DvidMakesThings/HW_DataForge-DAQ/src/COMPONENTS.md

## Core Microcontroller

- **RP2354B**: Dual Cortex-M33 or Hazard3 RISC-V processors at 150 MHz.
- **Integrated ADC**: 8 channels, used for general-purpose analog input.
- **Integrated UART, SPI, I2C, PWM**: For flexible communication and control.

## Networking

- **RTL8211F**: Gigabit Ethernet PHY.
  - Connects to the RP2354B via the RMII interface.
  - Requires a 25 MHz crystal for clock input.
  - Magnetics and RJ45 jack directly interface with the network.

## Analog Input Subsystem

- **ADS1255**: External 24-bit ADC for high-precision measurements (connected via SPI).
- **AD8253**: Programmable Gain Amplifier for scalable input ranges.
- **DG409**: Dual 4-channel analog multiplexer for input selection.
- **ADA4254**: Programmable Gain Instrumentation Amplifier for signal scaling and conditioning.

## Analog Output Subsystem

- **DAC8568**: 16-bit external DAC for generating 8-channel analog output.
- **TLV2372**: Operational amplifiers for output buffering.
- **Output Voltage Range**: Configurable from 0-5V.

## Digital I/O Subsystem

- **LSF0108-Q1**: Used for bidirectional translation between the RP2354B's GPIOs (3.3V logic) and external interfaces that might use different logic levels (e.g., 1.8V, 5V).

## Communication Subsystem

- **RS-232 and RS-485**:
  - MAX3232 and MAX485 for serial communication.
- **CAN**: MCP2515 (SPI-based CAN controller) with a TJA1051 transceiver.
- **USB**: Integrated USB 1.1 host/device controller in RP2354B for PC connectivity.

## Power Supply

- **Input Voltage Range**: 9-24V DC.
- **Voltage Regulation**:
  - LM2596 for 5V.
  - AMS1117 for 3.3V (RP2354B and peripherals).
- **Protection**:
  - Reverse polarity and overvoltage protection.
  - ESD diodes on all power and communication lines.
