DvidMakesThings/HW_DataForge-DAQ/tests/Readme.md

# DataForge-DAQ Project Test files
This folder contains the main test files for the DataForge-DAQ project.
## Contents
- Various test scripts and files for the DataForge-DAQ project.
## Usage
1. Clone the repository.
2. Navigate to this folder.
3. Run the test scripts as needed.
## License
This project is licensed under the MIT License.
## Contact
For any questions or feedback, please contact:
- Email: [s.dvid@hotmail.com](mailto:s.dvid@hotmail.com)
- GitHub: [DvidMakesThings](https://github.com/DvidMakesThings)
