DvidMakesThings/HW_DataForge-DAQ/src/HardwareDesign/DataForge-DAQ_Schematics.pdf

Document Number: | REV: v1.0
Date: not saved! | Sheet: 1/7

## https://github.com/DvidMakesThings

# BLOCK DIAGRAM

USB-C | POWER DELIVERY

# BOOST INVERTER TPS65131

# DUAL LDO TPS7A39

V+
+12V
V-
-12V

# LDO

# REF

# LDO

3.3V

1.8V

2.5V

+/-15V

# REF/2

1.25V

5V | 5V

# ANALOG

INPUT MUX | CON2
| AI
ANALOG | AO

# OUTPUT

24 BIT ADC | PGA
MCU | CON1
DIOCON³ | INTERFACING

## TITLE:

## DataForge-DAQ

# 5V to +/-14V BOOST CONVERTER

# +/-14V to +/12V LDO

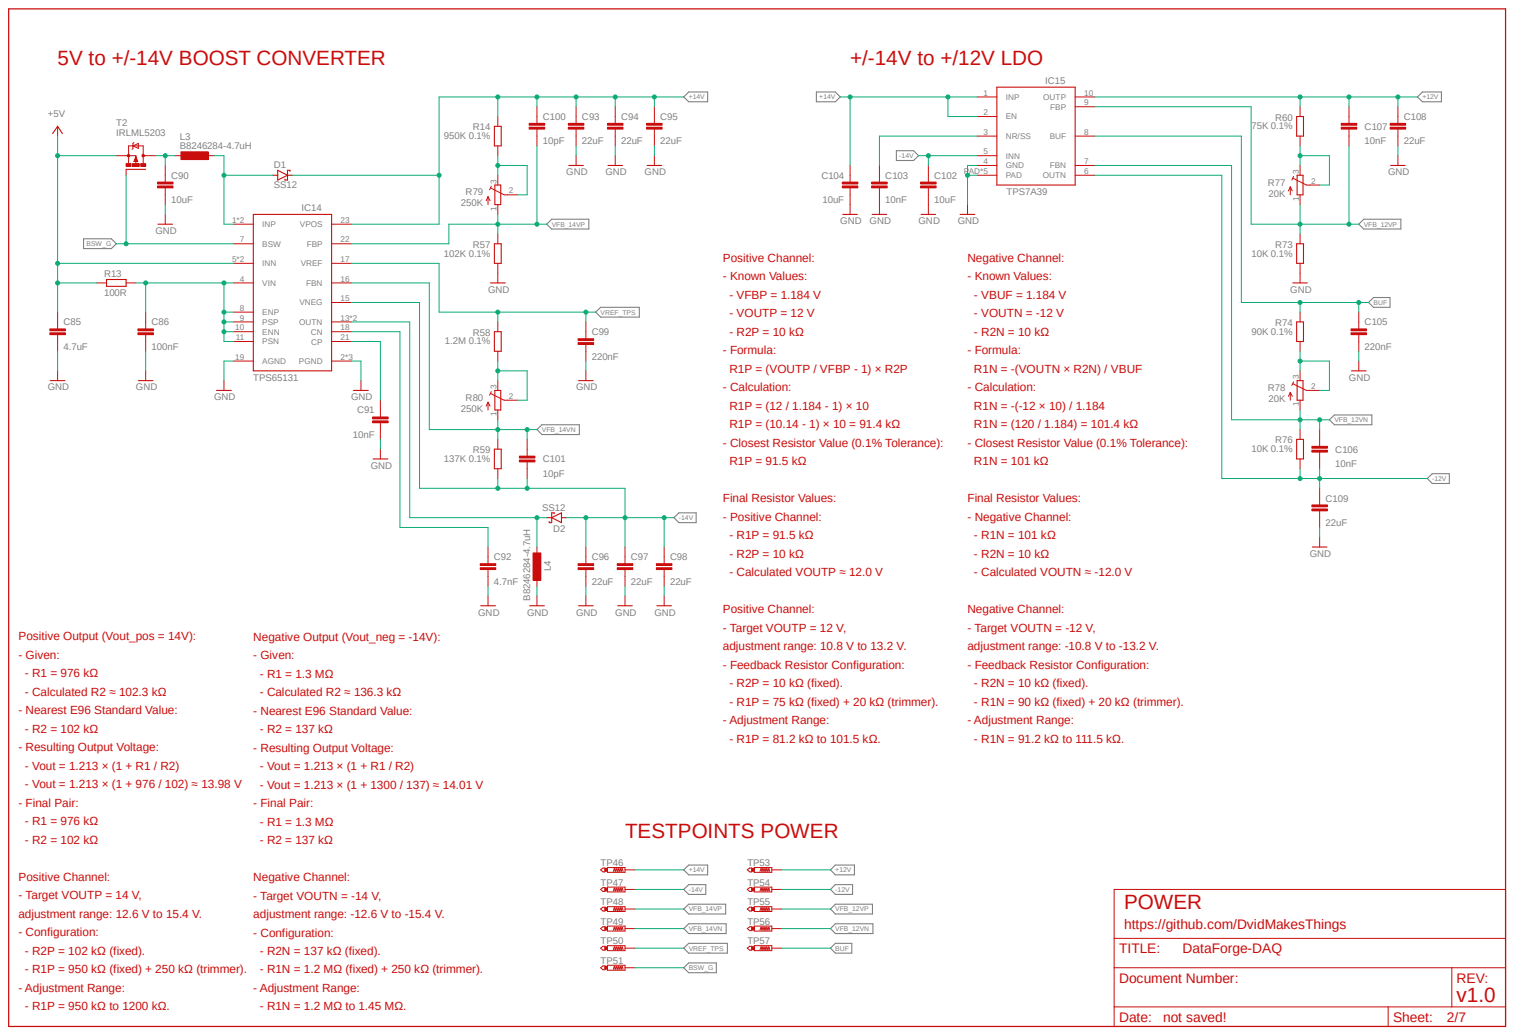
[picture p1: page 2]

Positive Channel:
- Target VOUTP = 12 V,
adjustment range: 10.8 V to 13.2 V.
- Feedback Resistor Configuration:
- R2P = 10 kΩ (fixed).
- R1P = 75 kΩ (fixed) + 20 kΩ (trimmer).
- Adjustment Range:

Negative Channel:
- Target VOUTN = -12 V,
adjustment range: -10.8 V to -13.2 V.
- R2N = 10 kΩ (fixed).
- R1N = 90 kΩ (fixed) + 20 kΩ (trimmer).

- Target VOUTP = 14 V,
adjustment range: 12.6 V to 15.4 V.
- Configuration:
- R2P = 102 kΩ (fixed).
- R1P = 950 kΩ (fixed) + 250 kΩ (trimmer).

- Target VOUTN = -14 V,
adjustment range: -12.6 V to -15.4 V.
- R2N = 137 kΩ (fixed).
- R1N = 1.2 MΩ (fixed) + 250 kΩ (trimmer).

POWER
https://github.com/DvidMakesThings
TITLE:

## CC1 D+D- CC2

# USB-C

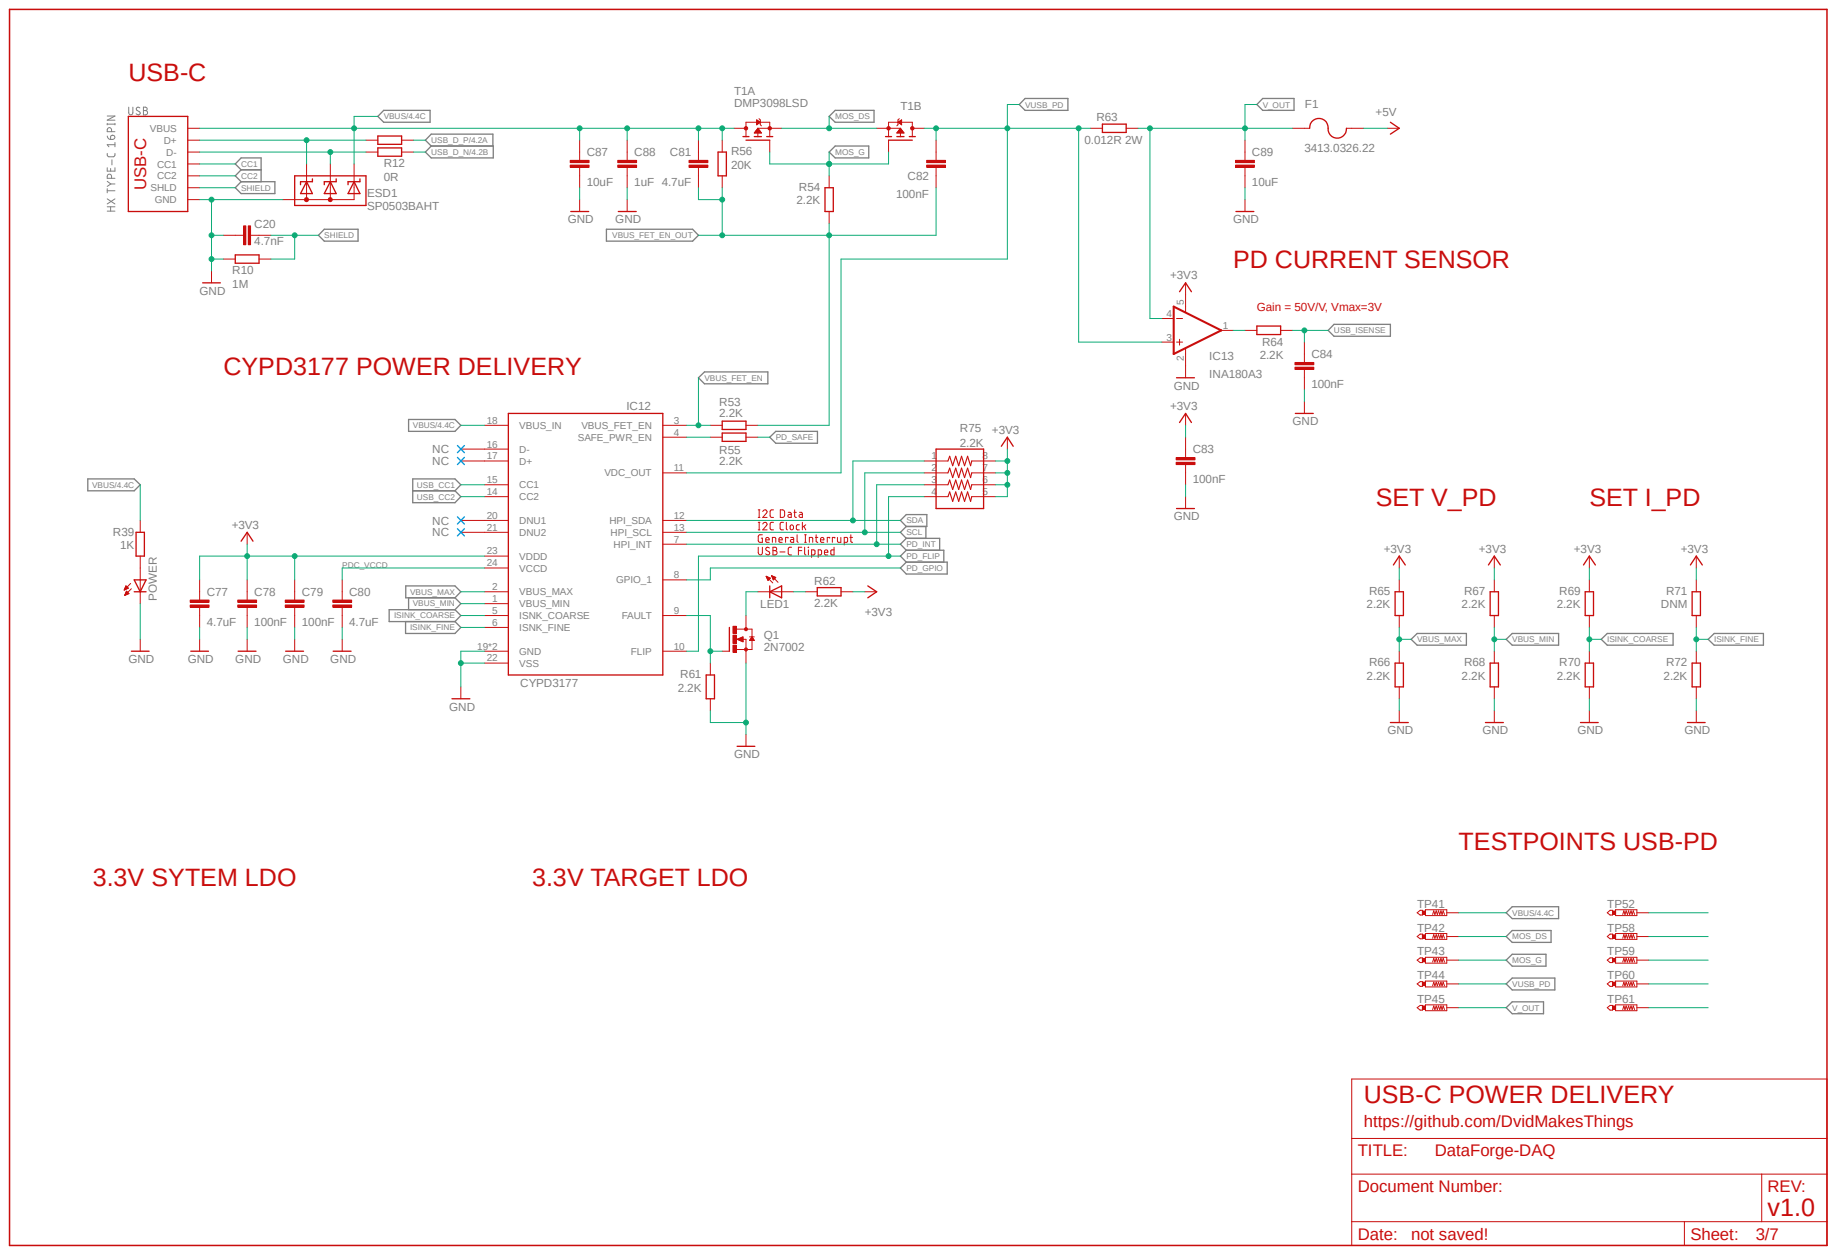
[picture p2: page 3]

USB-C POWER DELIVERY
https://github.com/DvidMakesThings
TITLE:

# RP2354 MCU

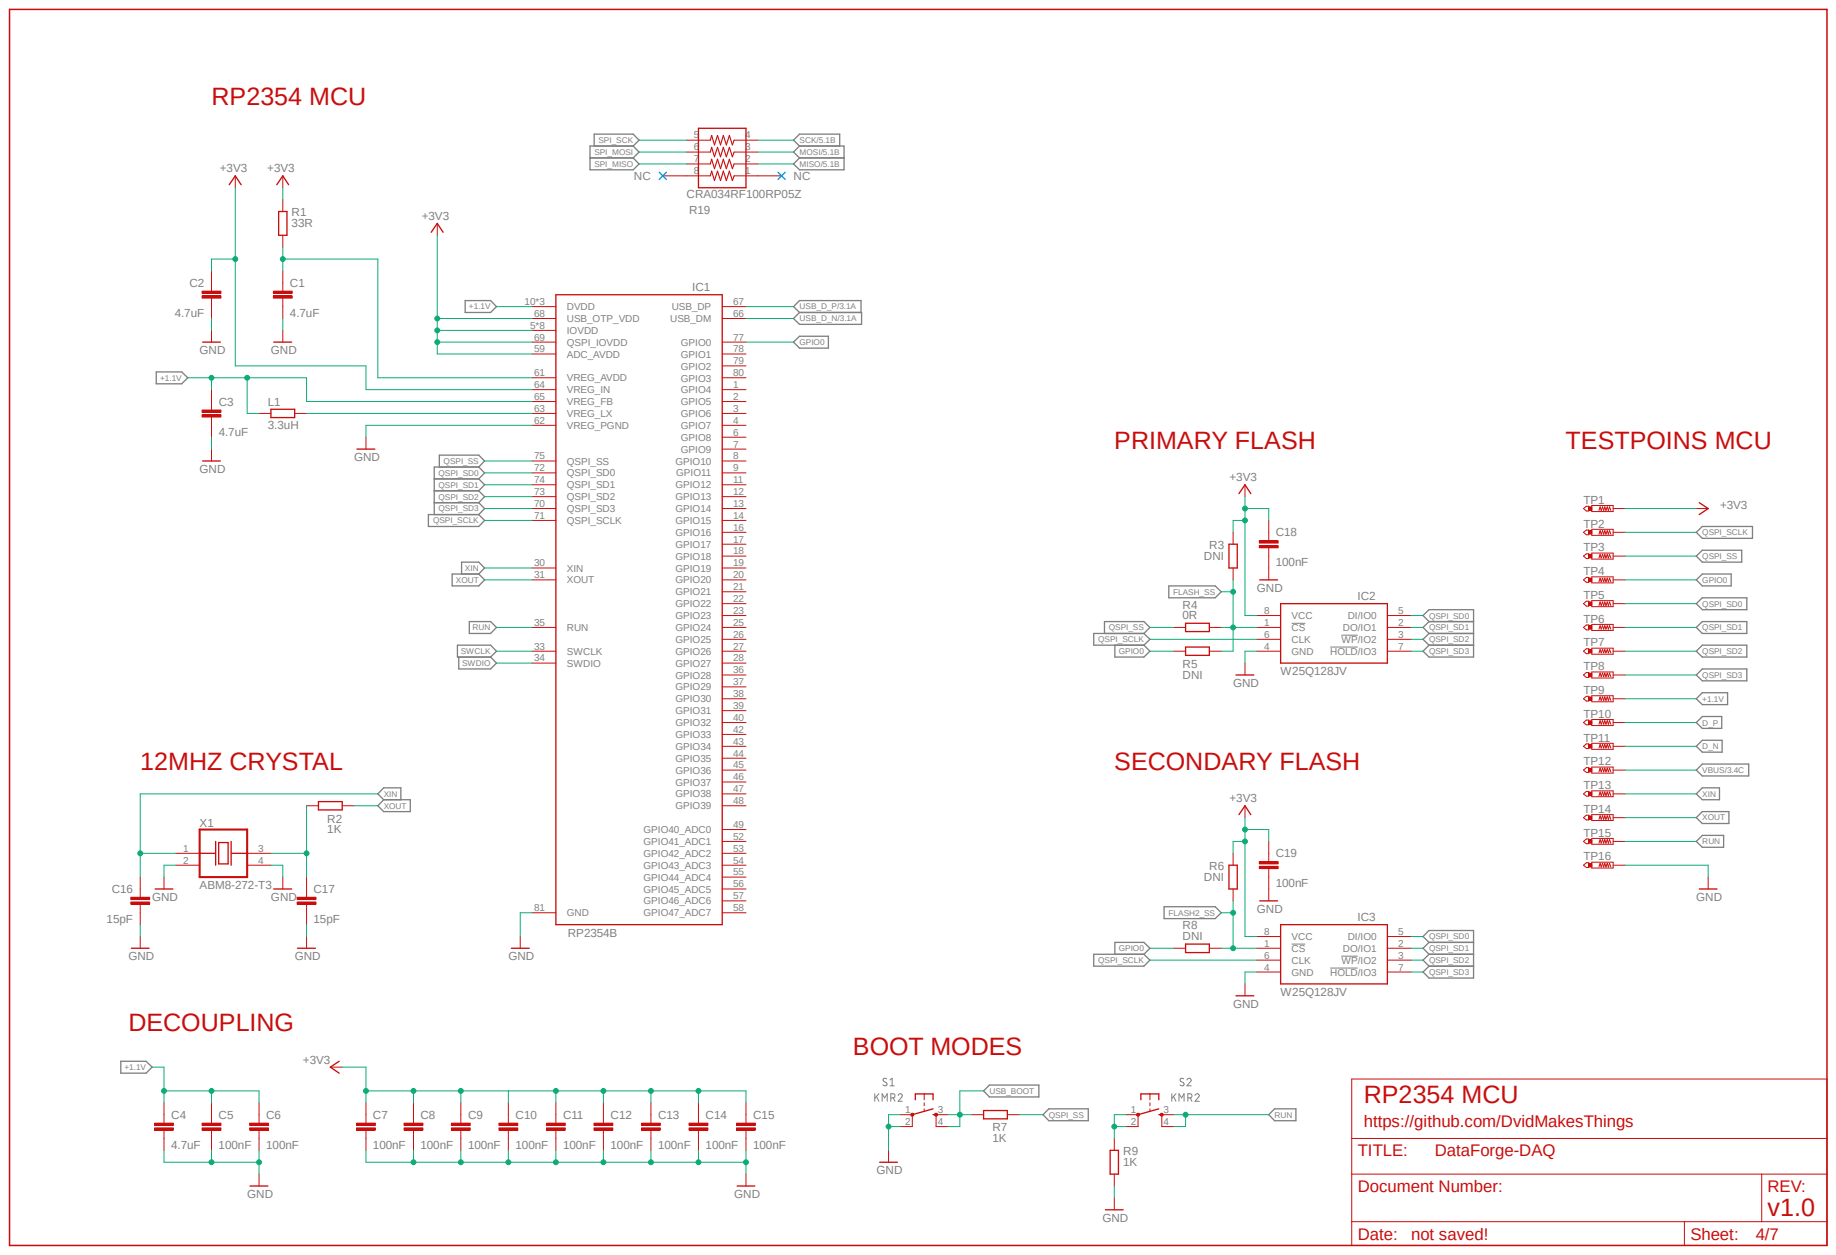
[picture p3: page 4]

RP2354 MCU
https://github.com/DvidMakesThings
TITLE:

A0 1 | EN 2 | A1 16 | V+ 14 | V- 3

# ADS1256 ADC

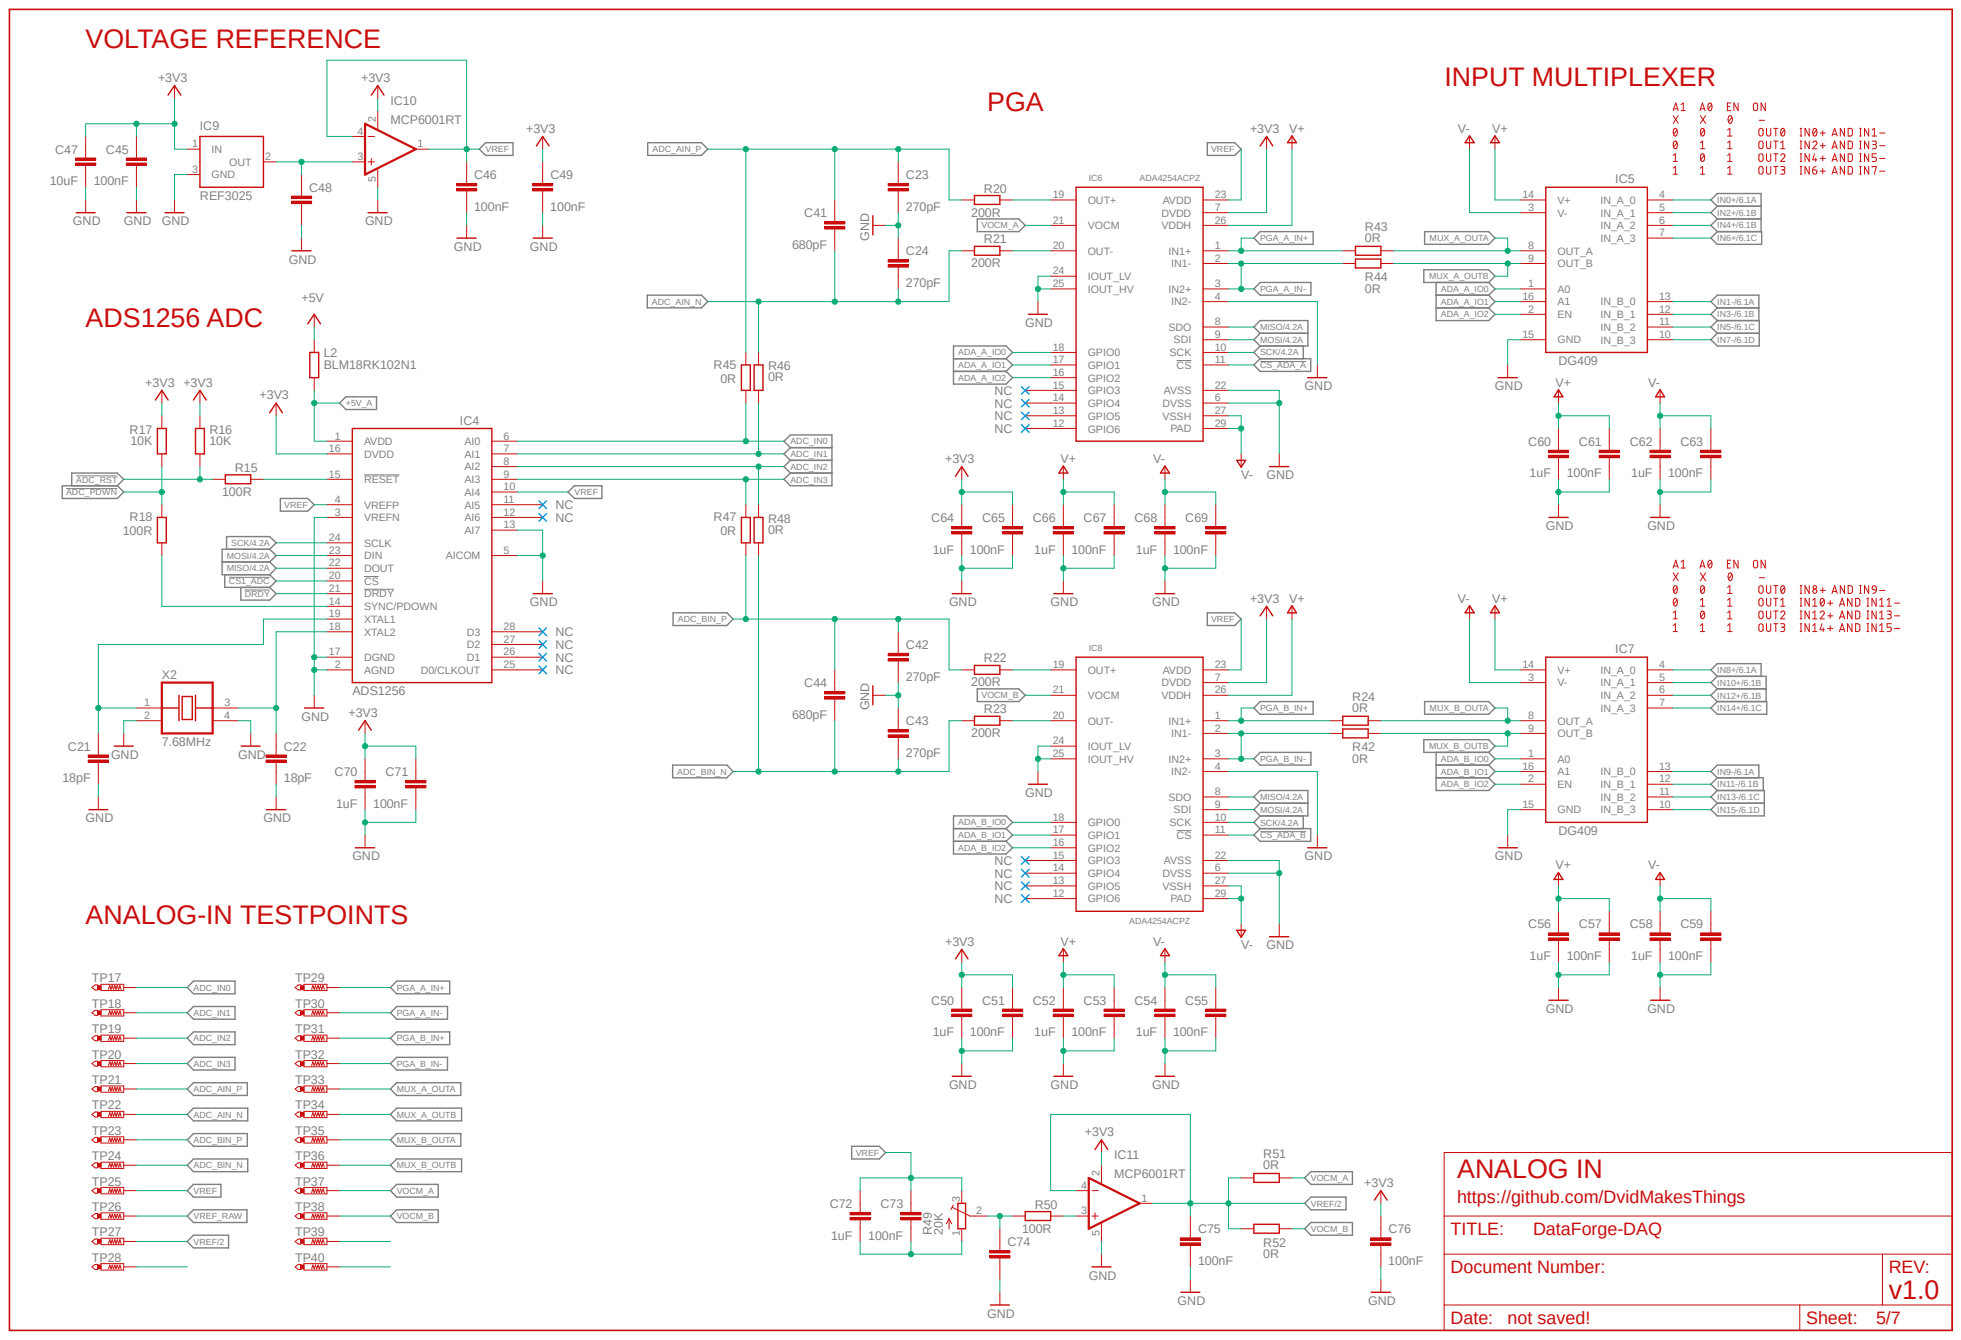
[picture p4: page 5]

ANALOG IN
https://github.com/DvidMakesThings
TITLE:

# ADC INPUTS

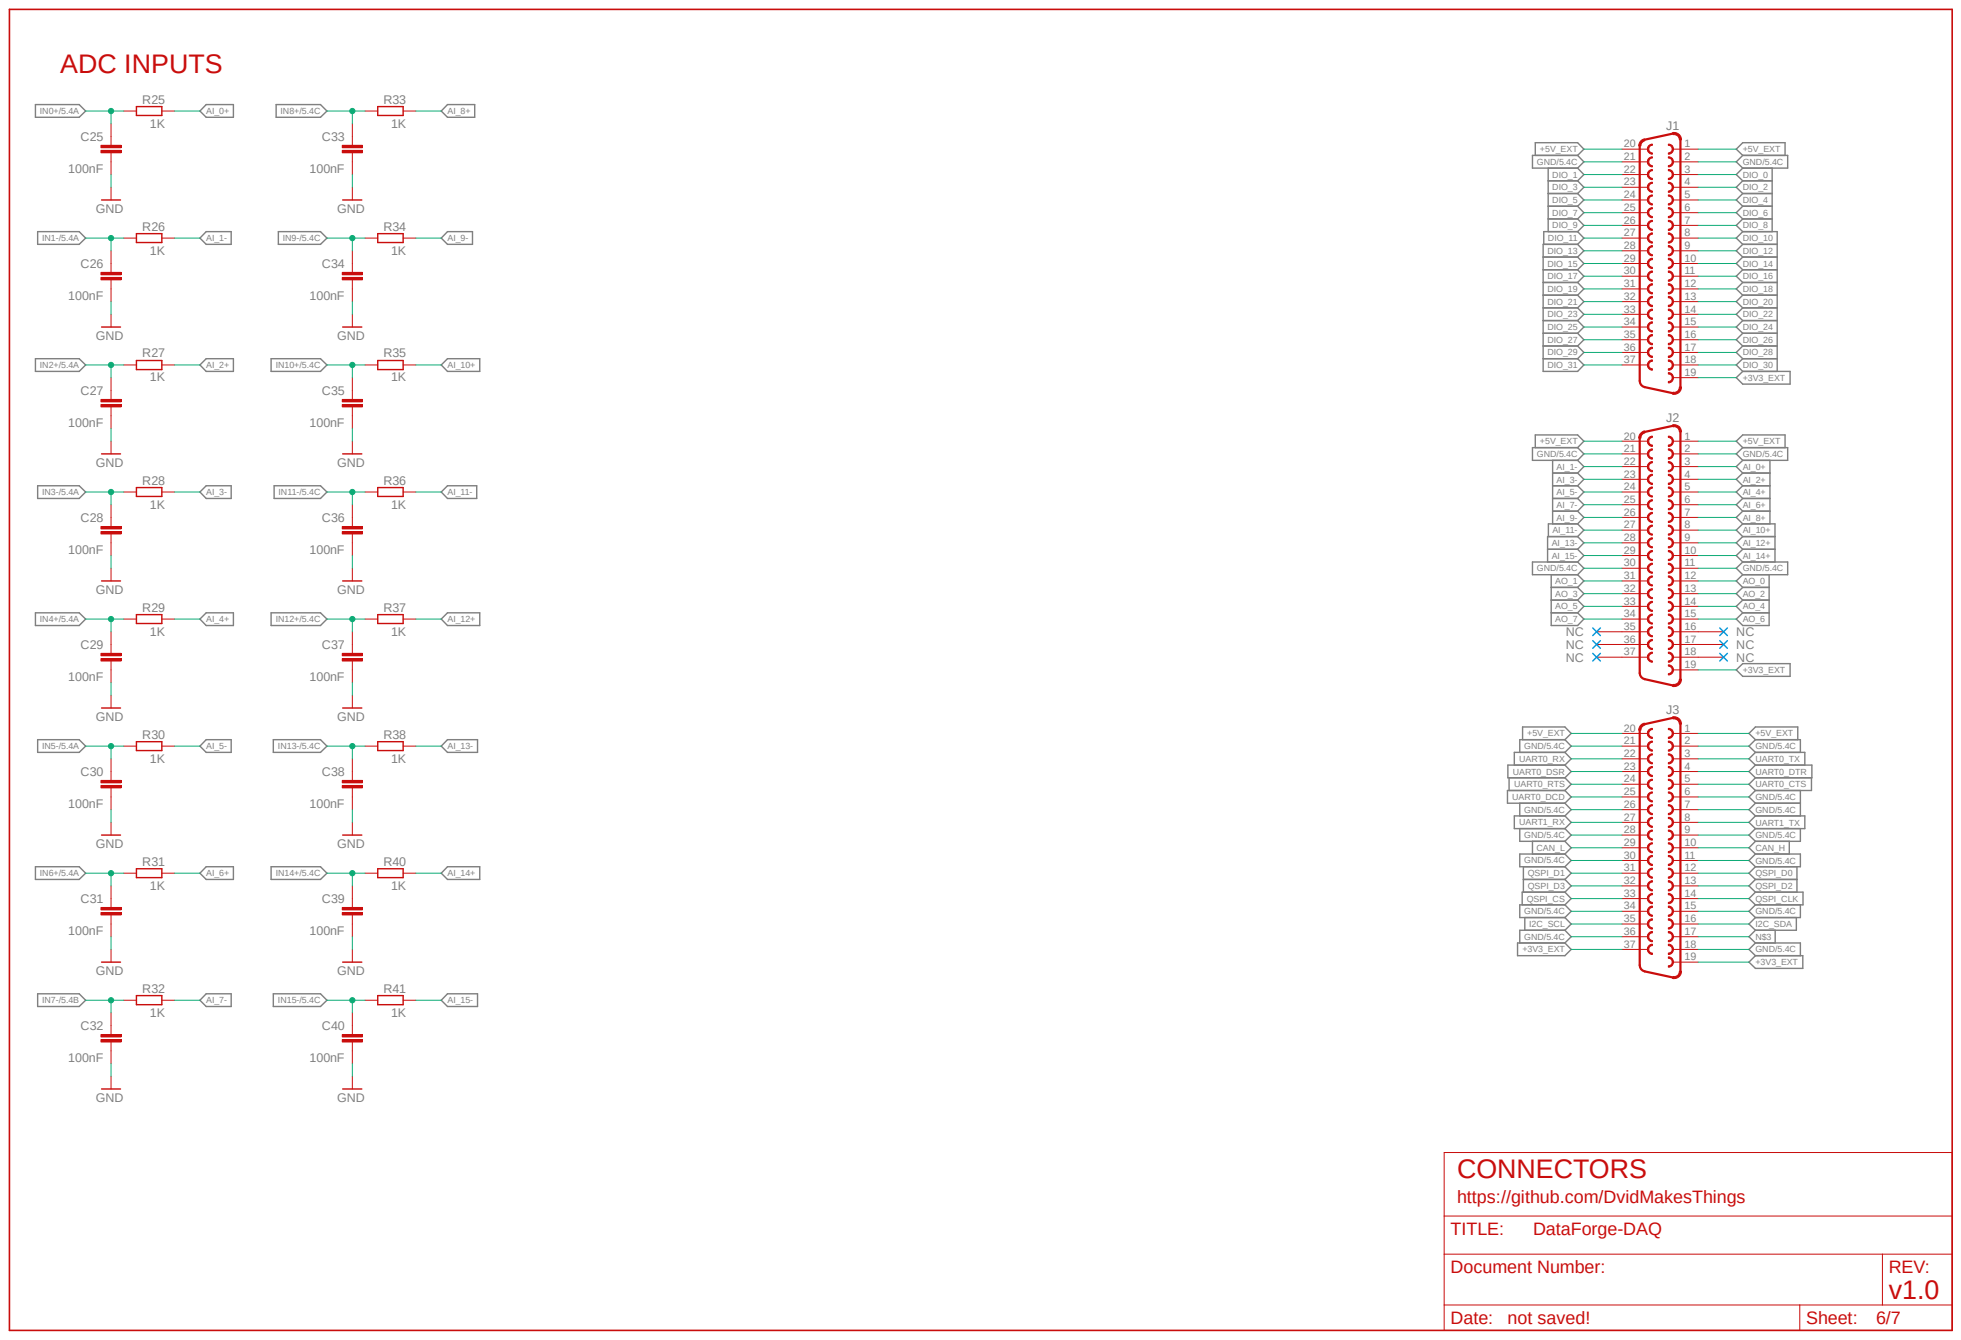
[picture p5: page 6]

CONNECTORS
https://github.com/DvidMakesThings
TITLE:
