DvidMakesThings/HW_DataForge-DAQ/src/HardwareDesign/DataForge-DAQ.sch

## EAGLE design src/HardwareDesign/DataForge-DAQ.sch (2024-12-25)

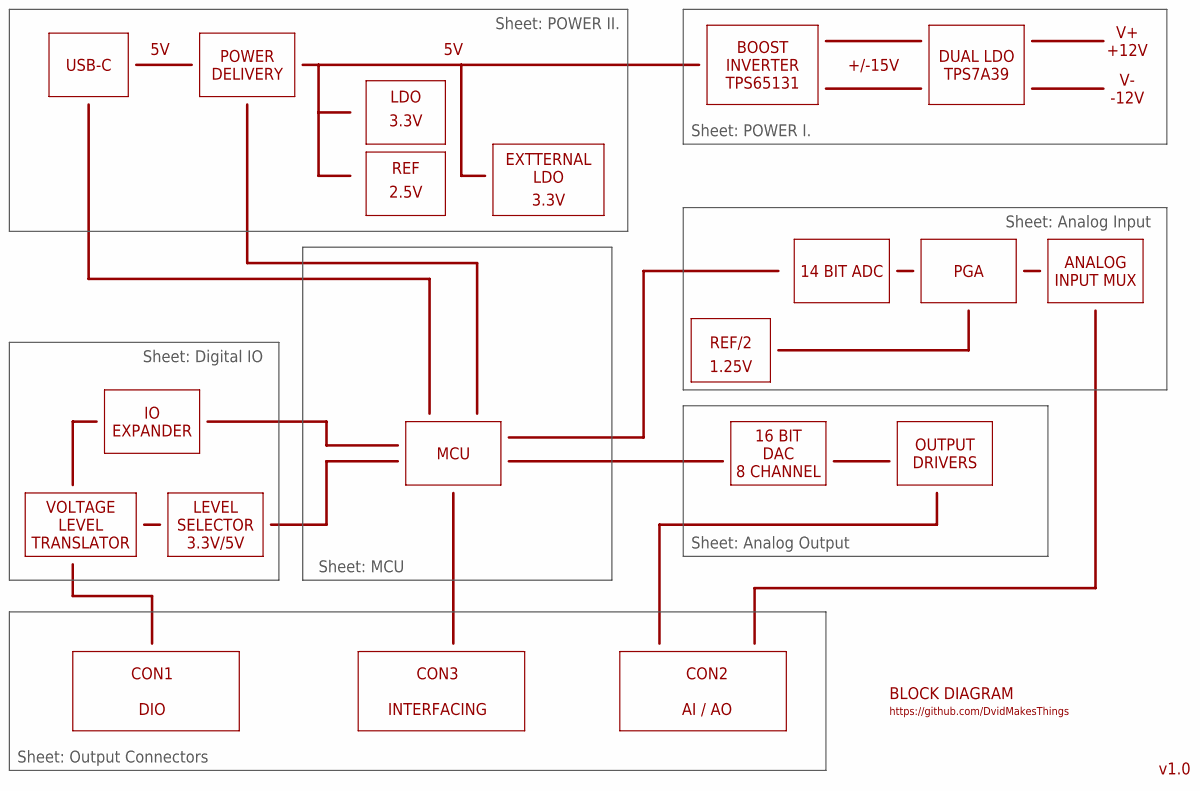
[picture p6: schematic DataForge-DAQ.sch, sheet 1]

Notes on the sheet:
v1.0
https://github.com/DvidMakesThings
BLOCK DIAGRAM
USB-C
POWER DELIVERY
BOOST INVERTER TPS65131
DUAL LDO TPS7A39
V+ +12V
V- -12V
LDO
REF
3.3V
2.5V
+/-15V
REF/2
1.25V
ANALOG INPUT MUX
CON2 AI / AO
16 BIT DAC 8 CHANNEL
PGA
14 BIT ADC
MCU
CON1 DIO
CON3 INTERFACING
EXTTERNAL LDO
Sheet: POWER I.
Sheet: POWER II.
Sheet: MCU
Sheet: Analog Output
Sheet: Analog Input
Sheet: Output Connectors
Sheet: Digital IO
OUTPUT DRIVERS
VOLTAGE LEVEL TRANSLATOR
LEVEL SELECTOR 3.3V/5V
IO EXPANDER

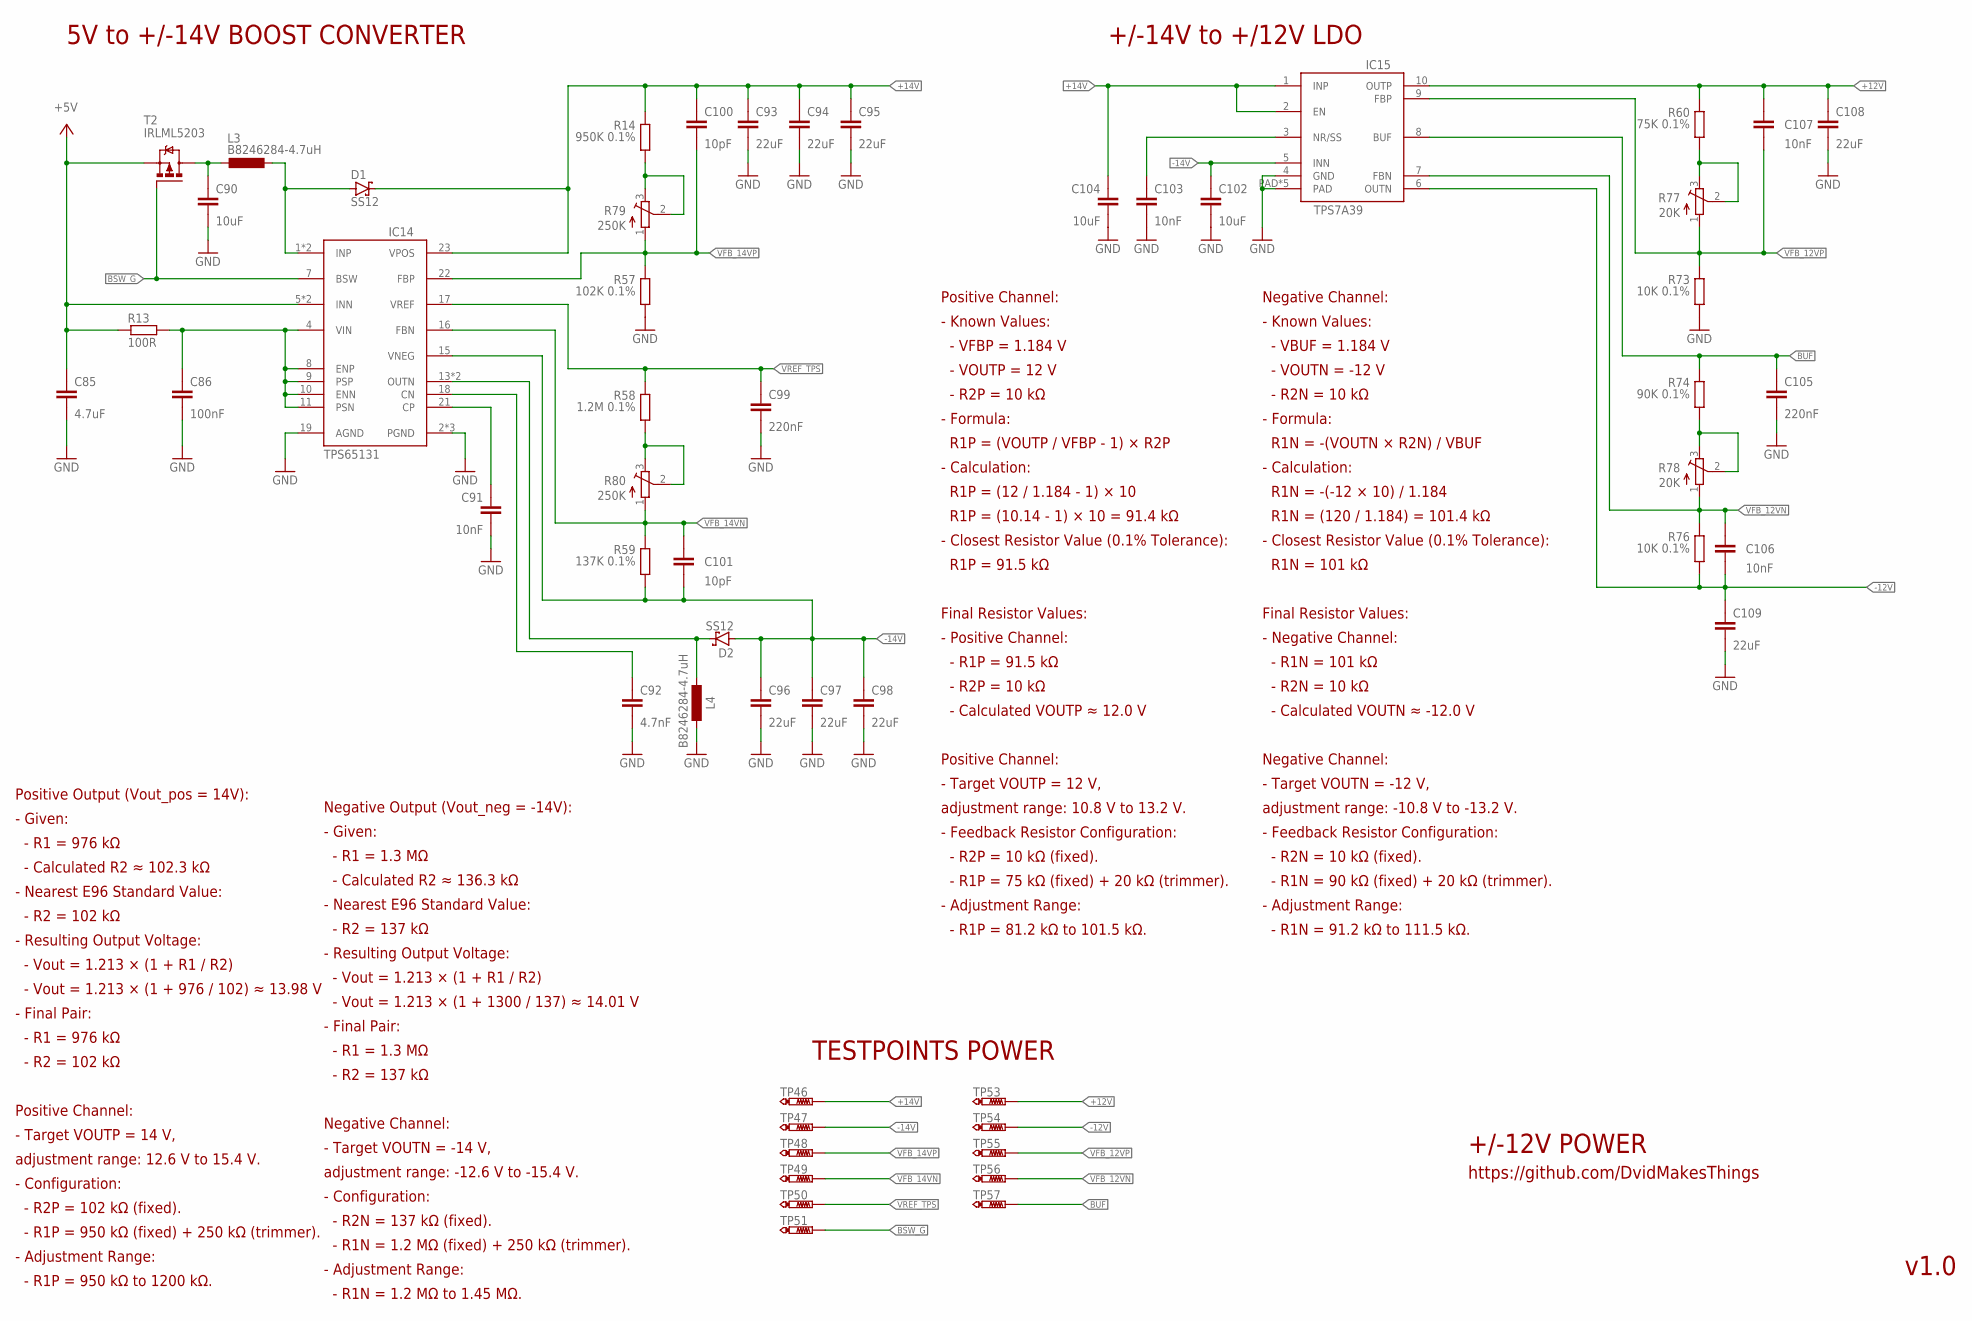
[picture p7: schematic DataForge-DAQ.sch, sheet 2]

Parts:
C85: 4.7uF; 0805
C86: 100nF; 0805
C90: 10uF; 0805
C91: 10nF; 0805
C92: 4.7nF; 0805
C93, C94, C95, C96, C97, C98, C108, C109: 22uF; 1206
C99, C105: 220nF; 0402
C100, C101: 10pF; 0402
C102, C104: 10uF; 1206
C103: 10nF; 1206
C106, C107: 10nF; 0402
D1, D2: SS12; SMA
IC14: TPS65131; VQFN24-4X4-THERMAL2.5X2.5
IC15: TPS7A39; WSON10-3X3
L3, L4: B8246284-4.7uH; MSS7341
R13: 100R; 1206
R14: 950K 0.1%; 0402
R57: 102K 0.1%; 0402
R58: 1.2M 0.1%; 0402
R59: 137K 0.1%; 0402
R60: 75K 0.1%; 0402
R73, R76: 10K 0.1%; 0402
R74: 90K 0.1%; 0402
R77, R78: 20K; 3223G
R79, R80: 250K; 3223G
T2: IRLML5203; MICRO3
TP46, TP47, TP48, TP49, TP50, TP51, TP53, TP54, TP55, TP56, TP57: PTR1B1,27; B1,27

Connections:
+5V: C85.1, IC14.5 (INN), R13.2, T2.2 (S)
+12V: C107.2, C108.1, IC15.10 (OUTP), R60.1, TP53.TP
+14V: C93.1, C94.1, C95.1, C100.1, C104.1, D1.C, IC14.23 (VPOS), IC15.1 (INP), IC15.2 (EN), R14.1, TP46.TP
-12V: C106.1, C109.1, IC15.6 (OUTN), R76.2, TP54.TP
-14V: C96.1, C97.1, C98.1, C101.1, C102.1, D2.A, IC14.15 (VNEG), IC15.5 (INN), R59.2, TP47.TP
BSW_G: IC14.7 (BSW), T2.1 (G), TP51.TP
BUF: C105.2, IC15.8 (BUF), R74.1, TP57.TP
GND: C85.2, C86.2, C90.2, C91.2, C92.2, C93.2, C94.2, C95.2, C96.2, C97.2, C98.2, C99.1, C102.2, C103.2, C104.2, C105.1, C108.2, C109.2, IC14.2 (PGND), IC14.19 (AGND), IC15.4 (GND), IC15.PAD, L4.1, R57.2, R73.2
unnamed: D1.A, IC14.1 (INP), L3.2
unnamed: C90.1, L3.1, T2.3 (D)
unnamed: C86.1, IC14.4 (VIN), IC14.8 (ENP), IC14.9 (PSP), IC14.10 (ENN), IC14.11 (PSN), R13.1
unnamed: C91.1, IC14.21 (CP)
unnamed: C92.1, IC14.18 (CN)
unnamed: D2.C, IC14.13 (OUTN), L4.2
unnamed: R60.2, R77.2 (S), R77.3 (E)
unnamed: C103.1, IC15.3 (NR/SS)
unnamed: R74.2, R78.2 (S), R78.3 (E)
unnamed: R14.2, R79.2 (S), R79.3 (E)
unnamed: R58.2, R80.2 (S), R80.3 (E)
VFB_12VN: C106.2, IC15.7 (FBN), R76.1, R78.1 (A), TP56.TP
VFB_12VP: C107.1, IC15.9 (FBP), R73.1, R77.1 (A), TP55.TP
VFB_14VN: C101.2, IC14.16 (FBN), R59.1, R80.1 (A), TP49.TP
VFB_14VP: C100.2, IC14.22 (FBP), R57.1, R79.1 (A), TP48.TP
VREF_TPS: C99.2, IC14.17 (VREF), R58.1, TP50.TP

Notes on the sheet:
v1.0
https://github.com/DvidMakesThings
+/-12V POWER
5V to +/-14V BOOST CONVERTER
Positive Output (Vout_pos = 14V): - Given: - R1 = 976 kΩ - Calculated R2 ≈ 102.3 kΩ - Nearest E96 Standard Value: - R2 = 102 kΩ - Resulting Output Voltage: - Vout = 1.213 × (1 + R1 / R2) - Vout = 1.213 × (1 + 976 / 102) ≈ 13.98 V - Final Pair: - R1 = 976 kΩ - R2 = 102 kΩ Positive Channel: - Target 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
Negative Output (Vout_neg = -14V): - Given: - R1 = 1.3 MΩ - Calculated R2 ≈ 136.3 kΩ - Nearest E96 Standard Value: - R2 = 137 kΩ - Resulting Output Voltage: - Vout = 1.213 × (1 + R1 / R2) - Vout = 1.213 × (1 + 1300 / 137) ≈ 14.01 V - Final Pair: - R1 = 1.3 MΩ - R2 = 137 kΩ Negative Channel: - Targe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
Positive Channel: - Known Values: - VFBP = 1.184 V - VOUTP = 12 V - R2P = 10 kΩ - Formula: R1P = (VOUTP / VFBP - 1) × R2P - Calculation: R1P = (12 / 1.184 - 1) × 10 R1P = (10.14 - 1) × 10 = 91.4 kΩ - Closest Resistor Value (0.1% Tolerance): R1P = 91.5 kΩ Final Resistor Values: - Positive Channel: -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
Negative Channel: - Known Values: - VBUF = 1.184 V - VOUTN = -12 V - R2N = 10 kΩ - Formula: R1N = -(VOUTN × R2N) / VBUF - Calculation: R1N = -(-12 × 10) / 1.184 R1N = (120 / 1.184) = 101.4 kΩ - Closest Resistor Value (0.1% Tolerance): R1N = 101 kΩ Final Resistor Values: - Negative Channel: - R1N = 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
+/-14V to +/12V LDO
TESTPOINTS POWER

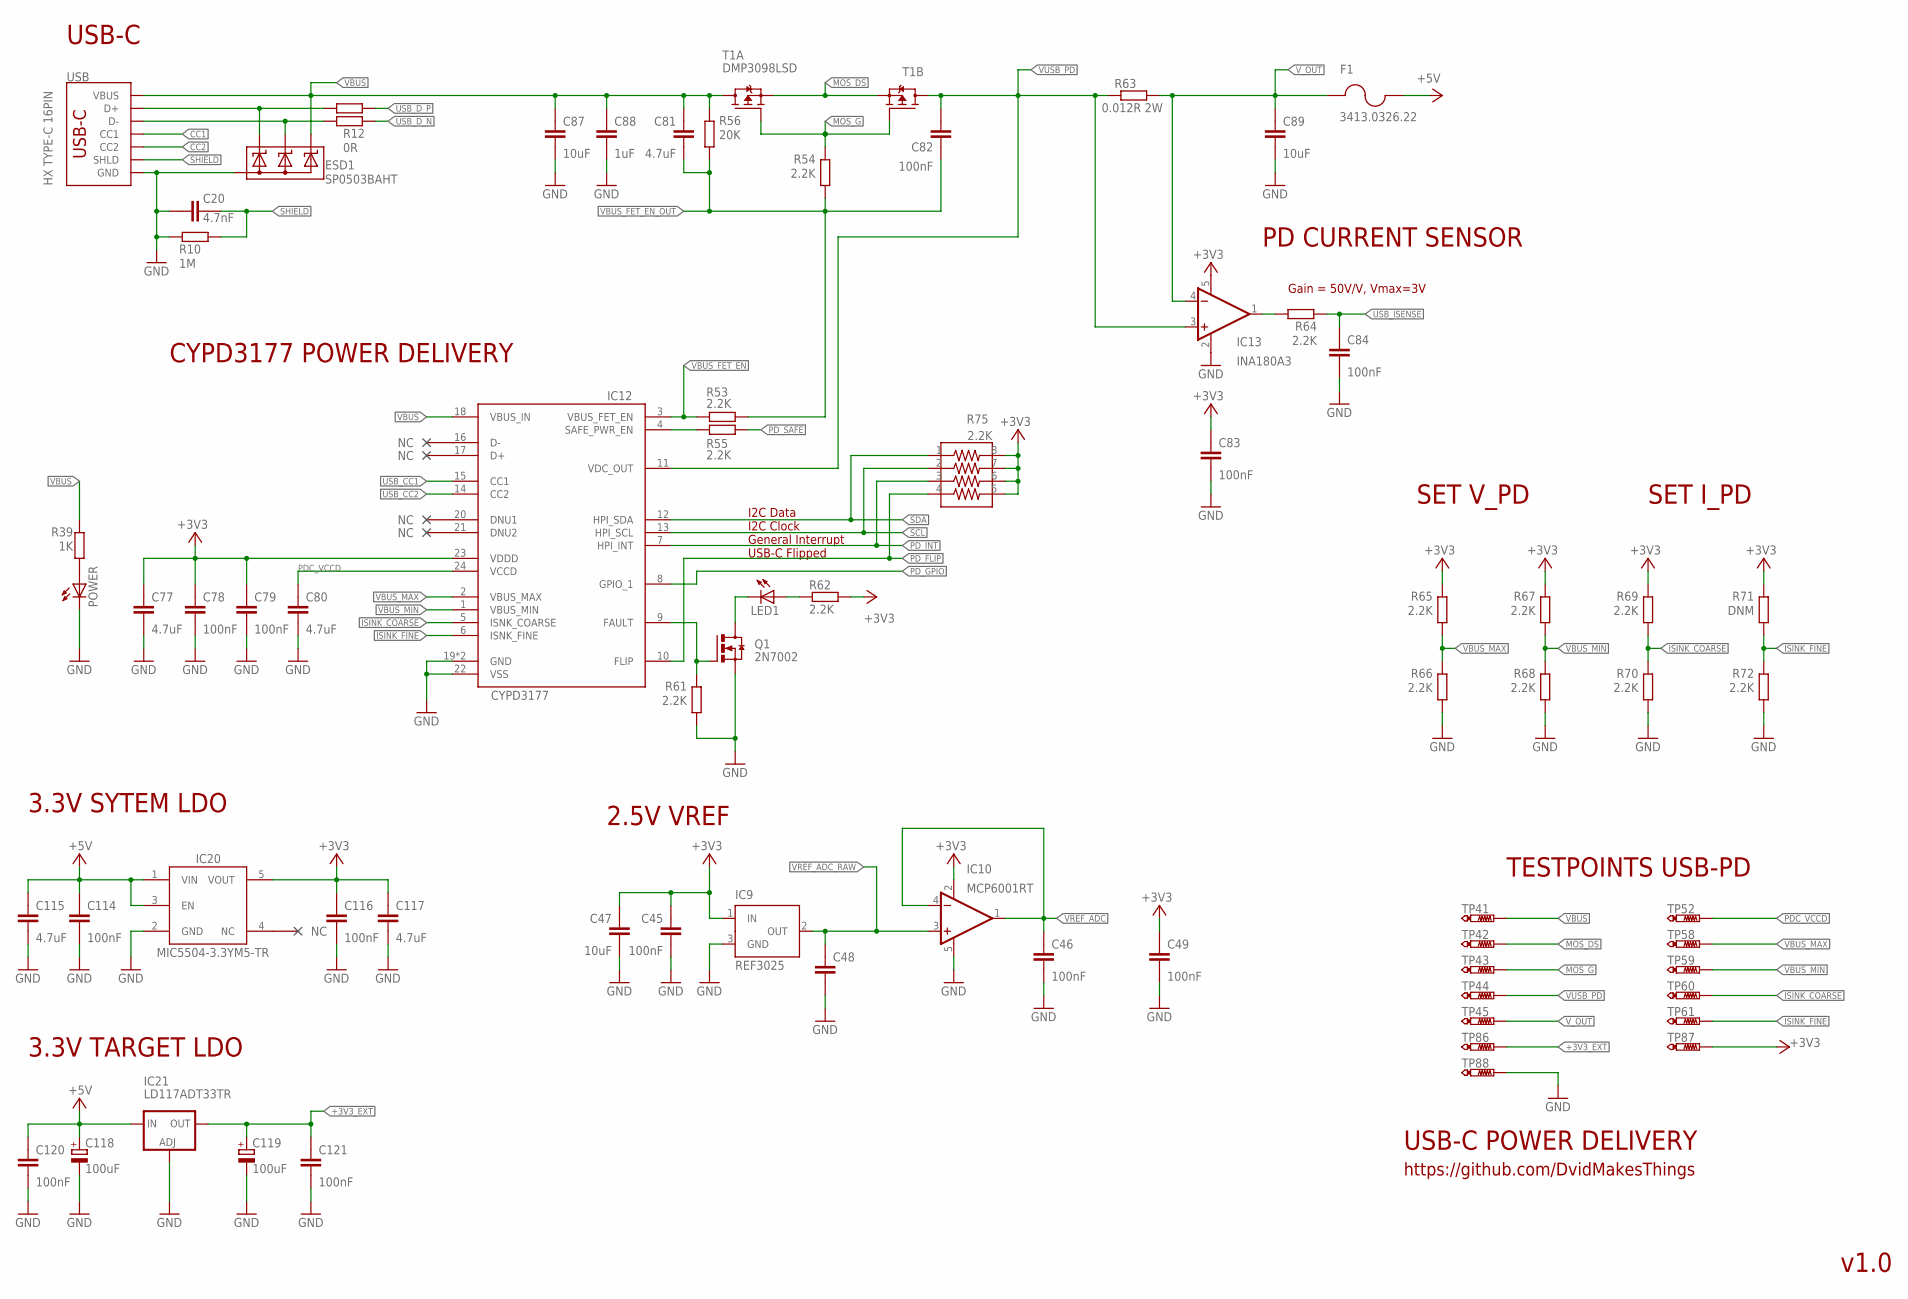
[picture p8: schematic DataForge-DAQ.sch, sheet 3]

Parts:
C20: 4.7nF; 0402
C45, C46, C49, C78, C79, C82, C83, C84, C114, C116, C120, C121: 100nF; 0402
C47: 10uF; 0805
C48: C0805; 0805
C77, C80, C81, C115, C117: 4.7uF; 0603
C87, C89: 10uF; 1206
C88: 1uF; 1206
C118, C119: 100uF; 153CLV-0605
ESD1: SP0503BAHT; SOT143
F1: 3413.0326.22
IC9: REF3025; SOT23
IC10: MCP6001RT; SOT23-5
IC12: CYPD3177; QFN50P400X400X60-25T275N
IC13: INA180A3; SOT23-5
IC20: MIC5504-3.3YM5-TR; SOT23-5
IC21: LD117ADT33TR; DPACK
LED1: LEDCHIP-LED0805; CHIP-LED0805
POWER: 19-213/Y2C-CQ2R2L/3T(CY); CHIP-LED0603
Q1: 2N7002; SOT23-3
R10: 1M; 0402
R11, R12: 0R; R0402
R39: 1K; R0402
R53, R54, R55, R61, R62, R64, R65, R66, R67, R68, R69, R70, R72: 2.2K; 0402
R56: 20K; 0402
R63: 0.012R 2W; R2512
R71: DNM; 0402
R75: 2.2K; 742C083103JP
T1: DMP3098LSD; SO8
TP41, TP42, TP43, TP44, TP45, TP52, TP58, TP59, TP60, TP61, TP86, TP87, TP88: PTR1B1,27; B1,27
USB: HX TYPE-C 16PIN; USB-C-16P-2LAYER-PADS

Connections:
+3V3: C45.1, C47.1, C49.1, C77.1, C78.1, C79.1, C83.1, C116.1, C117.1, IC9.1 (IN), IC10.2 (V+), IC12.23 (VDDD), IC13.5 (V+), IC20.5 (VOUT), R62.1, R65.2, R67.2, R69.2, R71.2, R75.5, R75.6, R75.7, R75.8, TP87.TP
+3V3_EXT: C119.+, C121.1, IC21.4 (OUT), TP86.TP
+5V: C114.1, C115.1, C118.+, C120.1, F1.2, IC20.1 (VIN), IC20.3 (EN), IC21.3 (IN)
CC1: USB.A5 (CC1)
CC2: USB.B5 (CC2)
D_N1: ESD1.3 (C2), R12.2, USB.A7 (D-)
D_P1: ESD1.2 (C1), R11.2, USB.A6 (D+)
GND: C20.2, C45.2, C46.2, C47.2, C48.2, C49.2, C77.2, C78.2, C79.2, C80.2, C83.2, C84.2, C87.2, C88.2, C89.2, C114.2, C115.2, C116.2, C117.2, C118.-, C119.-, C120.2, C121.2, ESD1.1 (A), IC9.3 (GND), IC10.5 (V-), IC12.19 (GND), IC12.22 (VSS), IC13.2 (V-), IC20.2 (GND), IC21.1 (ADJ), POWER.C, Q1.2 (S), R10.1, R61.1, R66.1, R68.1, R70.1, R72.1, TP88.TP, USB.GND
ISINK_COARSE: IC12.5 (ISNK_COARSE), R69.1, R70.2, TP60.TP
ISINK_FINE: IC12.6 (ISNK_FINE), R71.1, R72.2, TP61.TP
MOS_DS: T1.1 (S), T1.3 (S), TP42.TP
MOS_G: R54.2, T1.2 (G), T1.4 (G), TP43.TP
unnamed: IC12.4 (SAFE_PWR_EN), R55.1
unnamed: IC12.9 (FAULT), Q1.1 (G), R61.2
unnamed: LED1.A, R62.2
unnamed: LED1.C, Q1.3 (D)
unnamed: IC13.1 (OUT), R64.2
unnamed: POWER.A, R39.2
PDC_VCCD: C80.1, IC12.24 (VCCD), TP52.TP
PD_FLIP: IC12.10 (FLIP), R75.4
PD_GPIO: IC12.8 (GPIO_1)
PD_INT: IC12.7 (HPI_INT), R75.3
PD_SAFE: R55.2
SCL: IC12.13 (HPI_SCL), R75.2
SDA: IC12.12 (HPI_SDA), R75.1
SHIELD: C20.1, R10.2, USB.SHLD1 (SHLD)
USB_CC1: IC12.15 (CC1)
USB_CC2: IC12.14 (CC2)
USB_D_N: R12.1
USB_D_P: R11.1
USB_ISENSE: C84.1, R64.1
VBUS: C81.1, C87.1, C88.1, ESD1.4 (C3), IC12.18 (VBUS_IN), R39.1, R56.2, T1.7 (D), TP41.TP, USB.VBUS1 (VBUS)
VBUS_FET_EN: IC12.3 (VBUS_FET_EN), R53.1
VBUS_FET_EN_OUT: C81.2, C82.2, R53.2, R54.1, R56.1
VBUS_MAX: IC12.2 (VBUS_MAX), R65.1, R66.2, TP58.TP
VBUS_MIN: IC12.1 (VBUS_MIN), R67.1, R68.2, TP59.TP
VREF_ADC: C46.1, IC10.1 (OUT), IC10.4 (-IN)
VREF_ADC_RAW: C48.1, IC9.2 (OUT), IC10.3 (+IN)
VUSB_PD: C82.1, IC12.11 (VDC_OUT), IC13.3 (+IN), R63.1, T1.5 (D), TP44.TP
V_OUT: C89.1, F1.1, IC13.4 (-IN), R63.2, TP45.TP

Notes on the sheet:
v1.0
https://github.com/DvidMakesThings
USB-C POWER DELIVERY
USB-C
I2C Data I2C Clock General Interrupt USB-C Flipped
Gain = 50V/V, Vmax=3V
SET V_PD
SET I_PD
TESTPOINTS USB-PD
CYPD3177 POWER DELIVERY
PD CURRENT SENSOR
3.3V SYTEM LDO
3.3V TARGET LDO
2.5V VREF

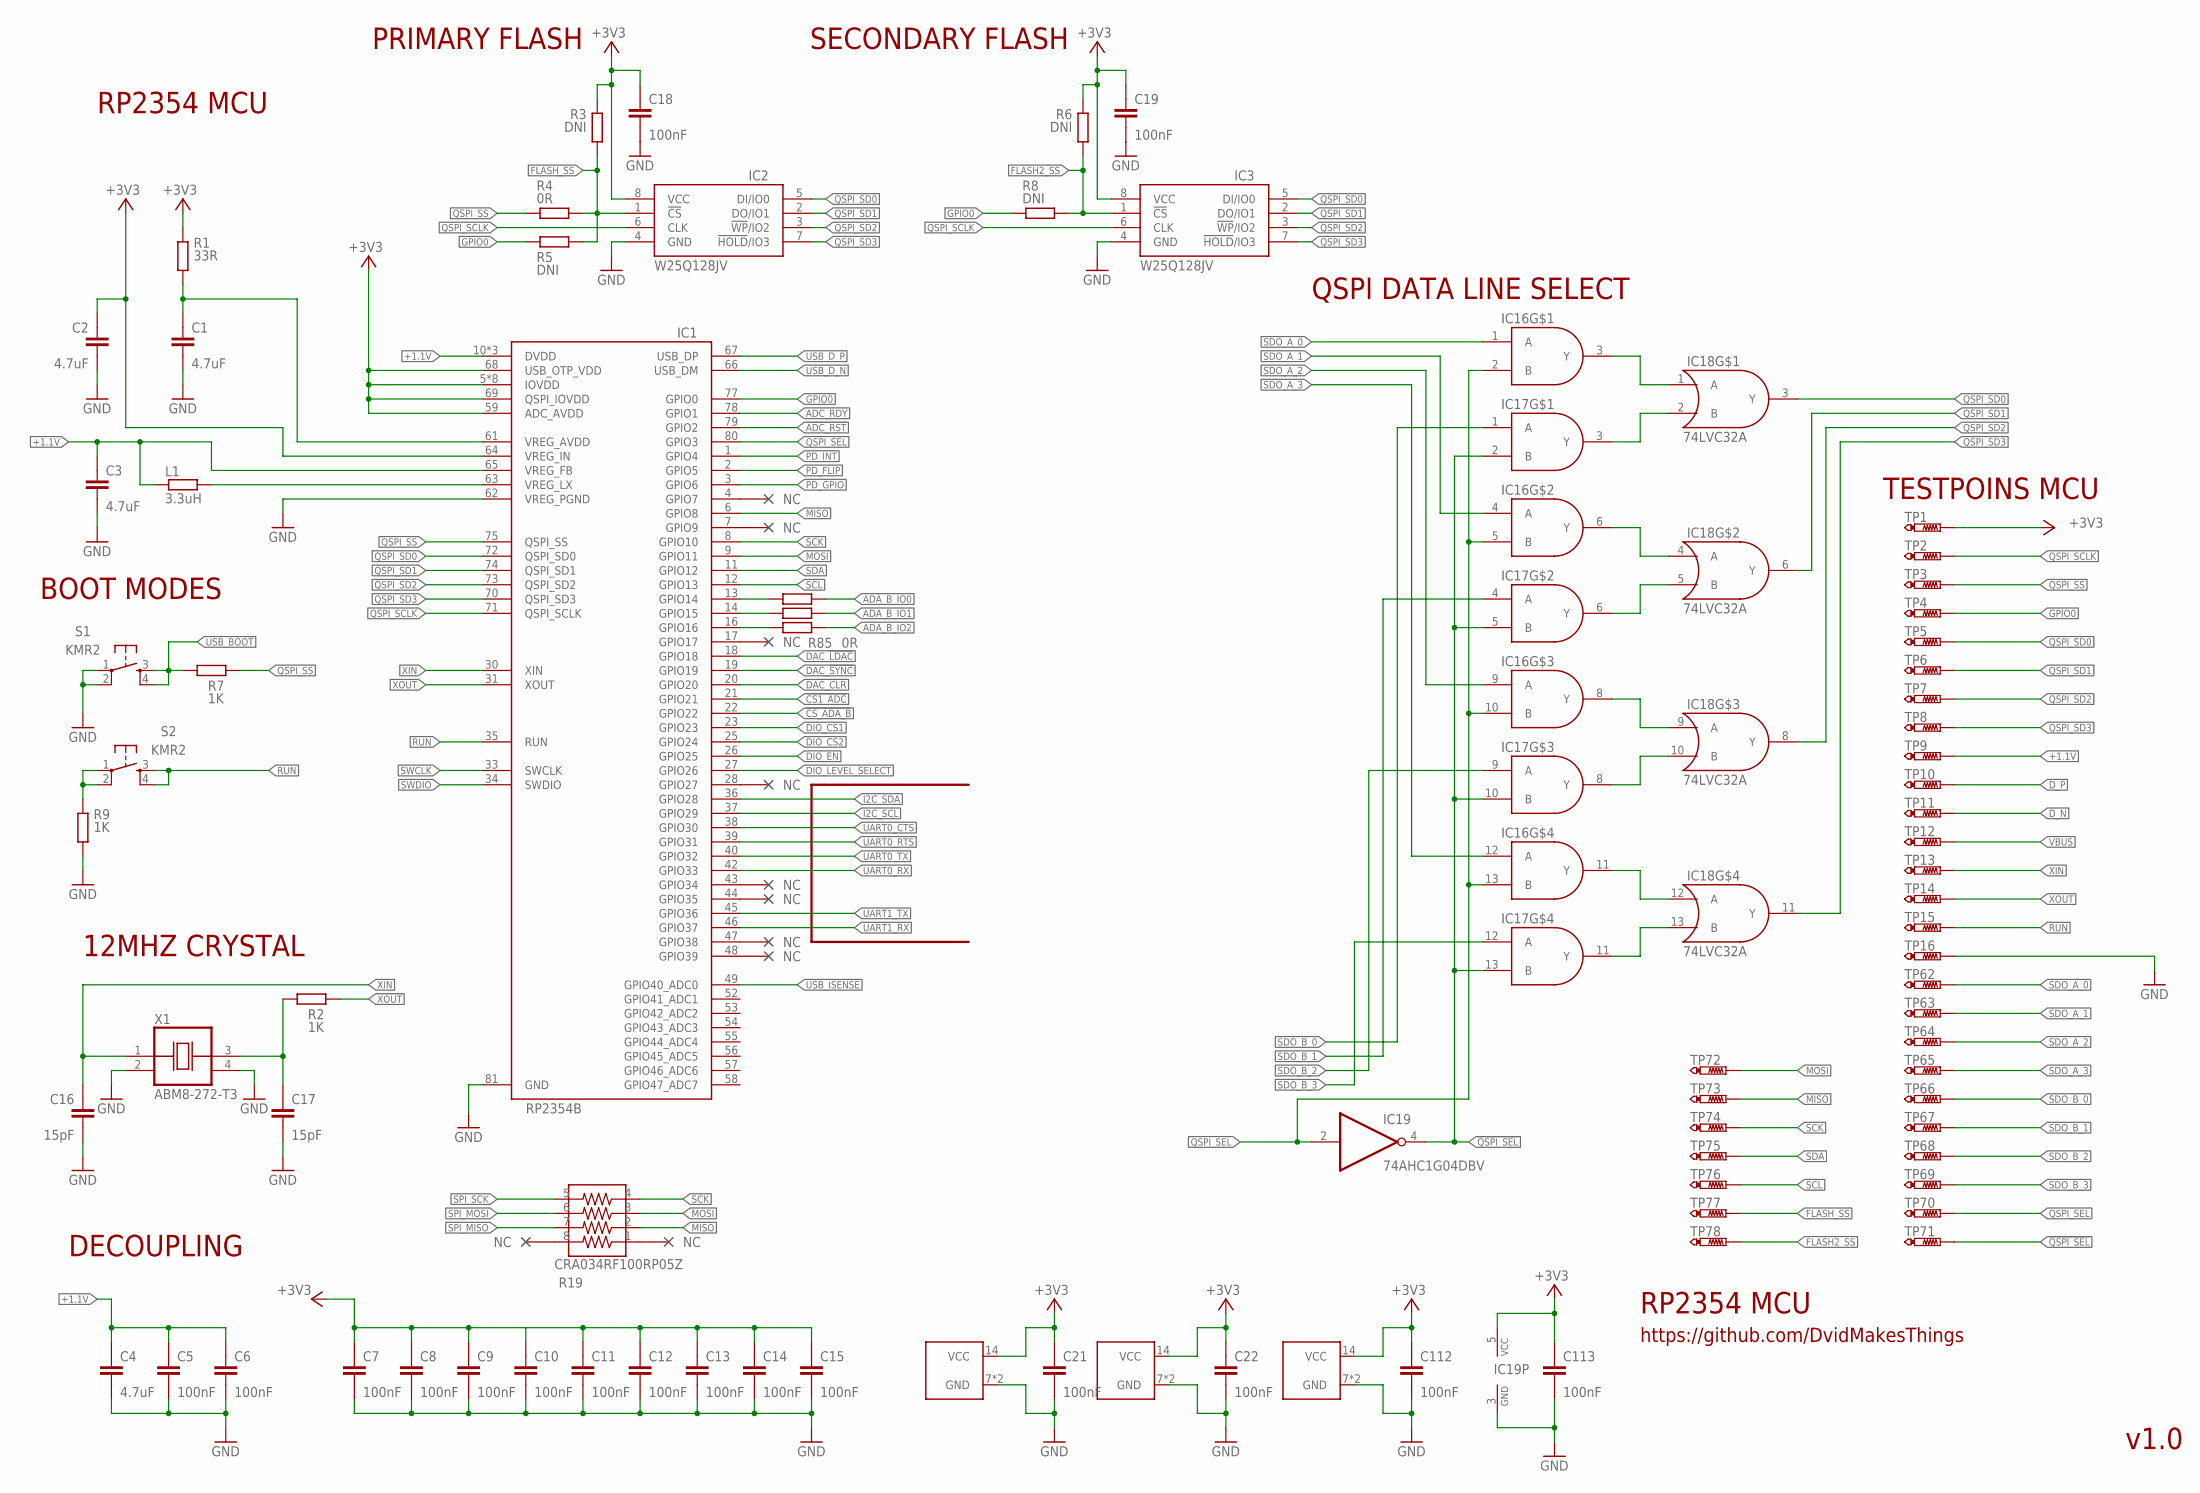
[picture p9: schematic DataForge-DAQ.sch, sheet 4]

Parts:
C1, C2, C3, C4: 4.7uF; 0402
C5, C6, C7, C8, C9, C10, C11, C12, C13, C14, C15, C18, C19, C21, C22, C112, C113: 100nF; 0402
C16, C17: 15pF; 0402
IC1: RP2354B; QFN40P1000X1000X85-81T340N
IC2, IC3: W25Q128JVP; SON127P600X500X75-8N
IC16, IC17: 74LVC08A; QFN50P250X300X100-15T100X150N
IC18: 74LVC32A; QFN50P250X300X100-15T100X150N
IC19: 74AHC1G04DBV; SOT23-5
L1: 3.3uH; 0805
R1: 33R; 0402
R2, R7, R9: 1K; 0402
R3, R5, R6, R8: DNI; 0402
R4, R83, R84, R85: 0R; 0402
R19: CRA034RF100RP05Z; YC164-JR-0733RL
S1, S2: KMR2; TACTILE_SWITCH_SMD_4.6X2.8MM
TP1, TP2, TP3, TP4, TP5, TP6, TP7, TP8, TP9, TP10, TP11, TP12, TP13, TP14, TP15, TP16, TP62, TP63, TP64, TP65, TP66, TP67, TP68, TP69, TP70, TP71, TP72, TP73, TP74, TP75, TP76, TP77, TP78: PTR1B1,27; B1,27
X1: ABM8-272-T3; OSCCC500X320X130

Connections:
!ADC_RST: IC1.79 (GPIO2)
!CS1_ADC: IC1.21 (GPIO21)
!CS_ADA_B: IC1.22 (GPIO22)
!QSPI_SEL: IC17.2 (B), IC17.5 (B), IC17.10 (B), IC17.13 (B), IC19.4 (O), TP71.TP
+1.1V: C3.1, C4.1, C5.1, C6.1, IC1.10 (DVDD), IC1.65 (VREG_FB), L1.1, TP9.TP
+3V3: C2.1, C7.1, C8.1, C9.1, C10.1, C11.1, C12.1, C13.1, C14.1, C15.1, C21.1, C22.1, C112.1, C113.1, IC1.5 (IOVDD), IC1.59 (ADC_AVDD), IC1.64 (VREG_IN), IC1.68 (USB_OTP_VDD), IC1.69 (QSPI_IOVDD), IC16.14 (VCC), IC17.14 (VCC), IC18.14 (VCC), IC19.5 (VCC), R1.1, TP1.TP
ADA_B_IO0: R83.1
ADA_B_IO1: R84.1
ADA_B_IO2: R85.1
ADC_RDY: IC1.78 (GPIO1)
DAC_!CLR: IC1.20 (GPIO20)
DAC_!LDAC: IC1.18 (GPIO18)
DAC_!SYNC: IC1.19 (GPIO19)
DIO_CS1: IC1.23 (GPIO23)
DIO_CS2: IC1.25 (GPIO24)
DIO_EN: IC1.26 (GPIO25)
DIO_LEVEL_SELECT: IC1.27 (GPIO26)
D_N: TP11.TP
D_P: TP10.TP
FLASH2_SS: IC3.1 (!CS), R6.2, R8.2, TP78.TP
FLASH_SS: IC2.1 (!CS), R3.2, R4.2, R5.2, TP77.TP
GND: C1.2, C2.2, C3.2, C4.2, C5.2, C6.2, C7.2, C8.2, C9.2, C10.2, C11.2, C12.2, C13.2, C14.2, C15.2, C16.2, C17.2, C18.2, C19.2, C21.2, C22.2, C112.2, C113.2, IC1.62 (VREG_PGND), IC1.81 (GND), IC2.4 (GND), IC3.4 (GND), IC16.7 (GND), IC17.7 (GND), IC18.7 (GND), IC19.3 (GND), R9.2, S1.1, S1.2, TP16.TP, X1.2 (VSS), X1.4 (VDD)
GPIO0: IC1.77 (GPIO0), R5.1, R8.1, TP4.TP
I2C_SCL: IC1.37 (GPIO29)
I2C_SDA: IC1.36 (GPIO28)
MISO: IC1.6 (GPIO8), R19.2, TP73.TP
MOSI: IC1.9 (GPIO11), R19.3, TP72.TP
unnamed: C1.1, IC1.61 (VREG_AVDD), R1.2
unnamed: IC1.63 (VREG_LX), L1.2
unnamed: R9.1, S2.1, S2.2
unnamed: IC16.3 (Y), IC18.1 (A)
unnamed: IC1.13 (GPIO14), R83.2
unnamed: IC17.3 (Y), IC18.2 (B)
unnamed: IC16.6 (Y), IC18.4 (A)
unnamed: IC17.6 (Y), IC18.5 (B)
unnamed: IC16.8 (Y), IC18.9 (A)
unnamed: IC1.14 (GPIO15), R84.2
unnamed: IC17.8 (Y), IC18.10 (B)
unnamed: IC16.11 (Y), IC18.12 (A)
unnamed: IC17.11 (Y), IC18.13 (B)
unnamed: IC1.16 (GPIO16), R85.2
PD_FLIP: IC1.2 (GPIO5)
PD_GPIO: IC1.3 (GPIO6)
PD_INT: IC1.1 (GPIO4)
QSPI_SCLK: IC1.71 (QSPI_SCLK), IC2.6 (CLK), IC3.6 (CLK), TP2.TP
QSPI_SD0: IC1.72 (QSPI_SD0), IC2.5 (DI/IO0), IC3.5 (DI/IO0), IC18.3 (Y), TP5.TP
QSPI_SD1: IC1.74 (QSPI_SD1), IC2.2 (DO/IO1), IC3.2 (DO/IO1), IC18.6 (Y), TP6.TP
QSPI_SD2: IC1.73 (QSPI_SD2), IC2.3 (!WP!/IO2), IC3.3 (!WP!/IO2), IC18.8 (Y), TP7.TP
QSPI_SD3: IC1.70 (QSPI_SD3), IC2.7 (!HOLD!/IO3), IC3.7 (!HOLD!/IO3), IC18.11 (Y), TP8.TP
QSPI_SEL: IC1.80 (GPIO3), IC16.2 (B), IC16.5 (B), IC16.10 (B), IC16.13 (B), IC19.2 (I), TP70.TP
QSPI_SS: IC1.75 (QSPI_SS), R4.1, R7.2, TP3.TP
RUN: IC1.35 (RUN), S2.3, S2.4, TP15.TP
SCK: IC1.8 (GPIO10), R19.4, TP74.TP
SCL: IC1.12 (GPIO13), TP76.TP
SDA: IC1.11 (GPIO12), TP75.TP
SDO_A_0: IC16.1 (A), TP62.TP
SDO_A_1: IC16.4 (A), TP63.TP
SDO_A_2: IC16.9 (A), TP64.TP
SDO_A_3: IC16.12 (A), TP65.TP
SDO_B_0: IC17.1 (A), TP66.TP
SDO_B_1: IC17.4 (A), TP67.TP
SDO_B_2: IC17.9 (A), TP68.TP
SDO_B_3: IC17.12 (A), TP69.TP
SPI_MISO: R19.7
SPI_MOSI: R19.6
SPI_SCK: R19.5
SWCLK: IC1.33 (SWCLK)
SWDIO: IC1.34 (SWDIO)
UART0_CTS: IC1.38 (GPIO30)
UART0_RTS: IC1.39 (GPIO31)
UART0_RX: IC1.42 (GPIO33)
UART0_TX: IC1.40 (GPIO32)
UART1_RX: IC1.46 (GPIO37)
UART1_TX: IC1.45 (GPIO36)
USB_BOOT: R7.1, S1.3, S1.4
USB_D_N: IC1.66 (USB_DM)
USB_D_P: IC1.67 (USB_DP)
USB_ISENSE: IC1.49 (GPIO40_ADC0)
VBUS: TP12.TP
VCC: C18.1, C19.1, IC2.8 (VCC), IC3.8 (VCC), R3.1, R6.1
XIN: C16.1, IC1.30 (XIN), TP13.TP, X1.1 (CON)
XOUT: IC1.31 (XOUT), R2.2, TP14.TP
XOUTC: C17.1, R2.1, X1.3 (OUT)

Notes on the sheet:
PRIMARY FLASH
SECONDARY FLASH
BOOT MODES
12MHZ CRYSTAL
DECOUPLING
RP2354 MCU
TESTPOINS MCU
v1.0
https://github.com/DvidMakesThings
QSPI DATA LINE SELECT

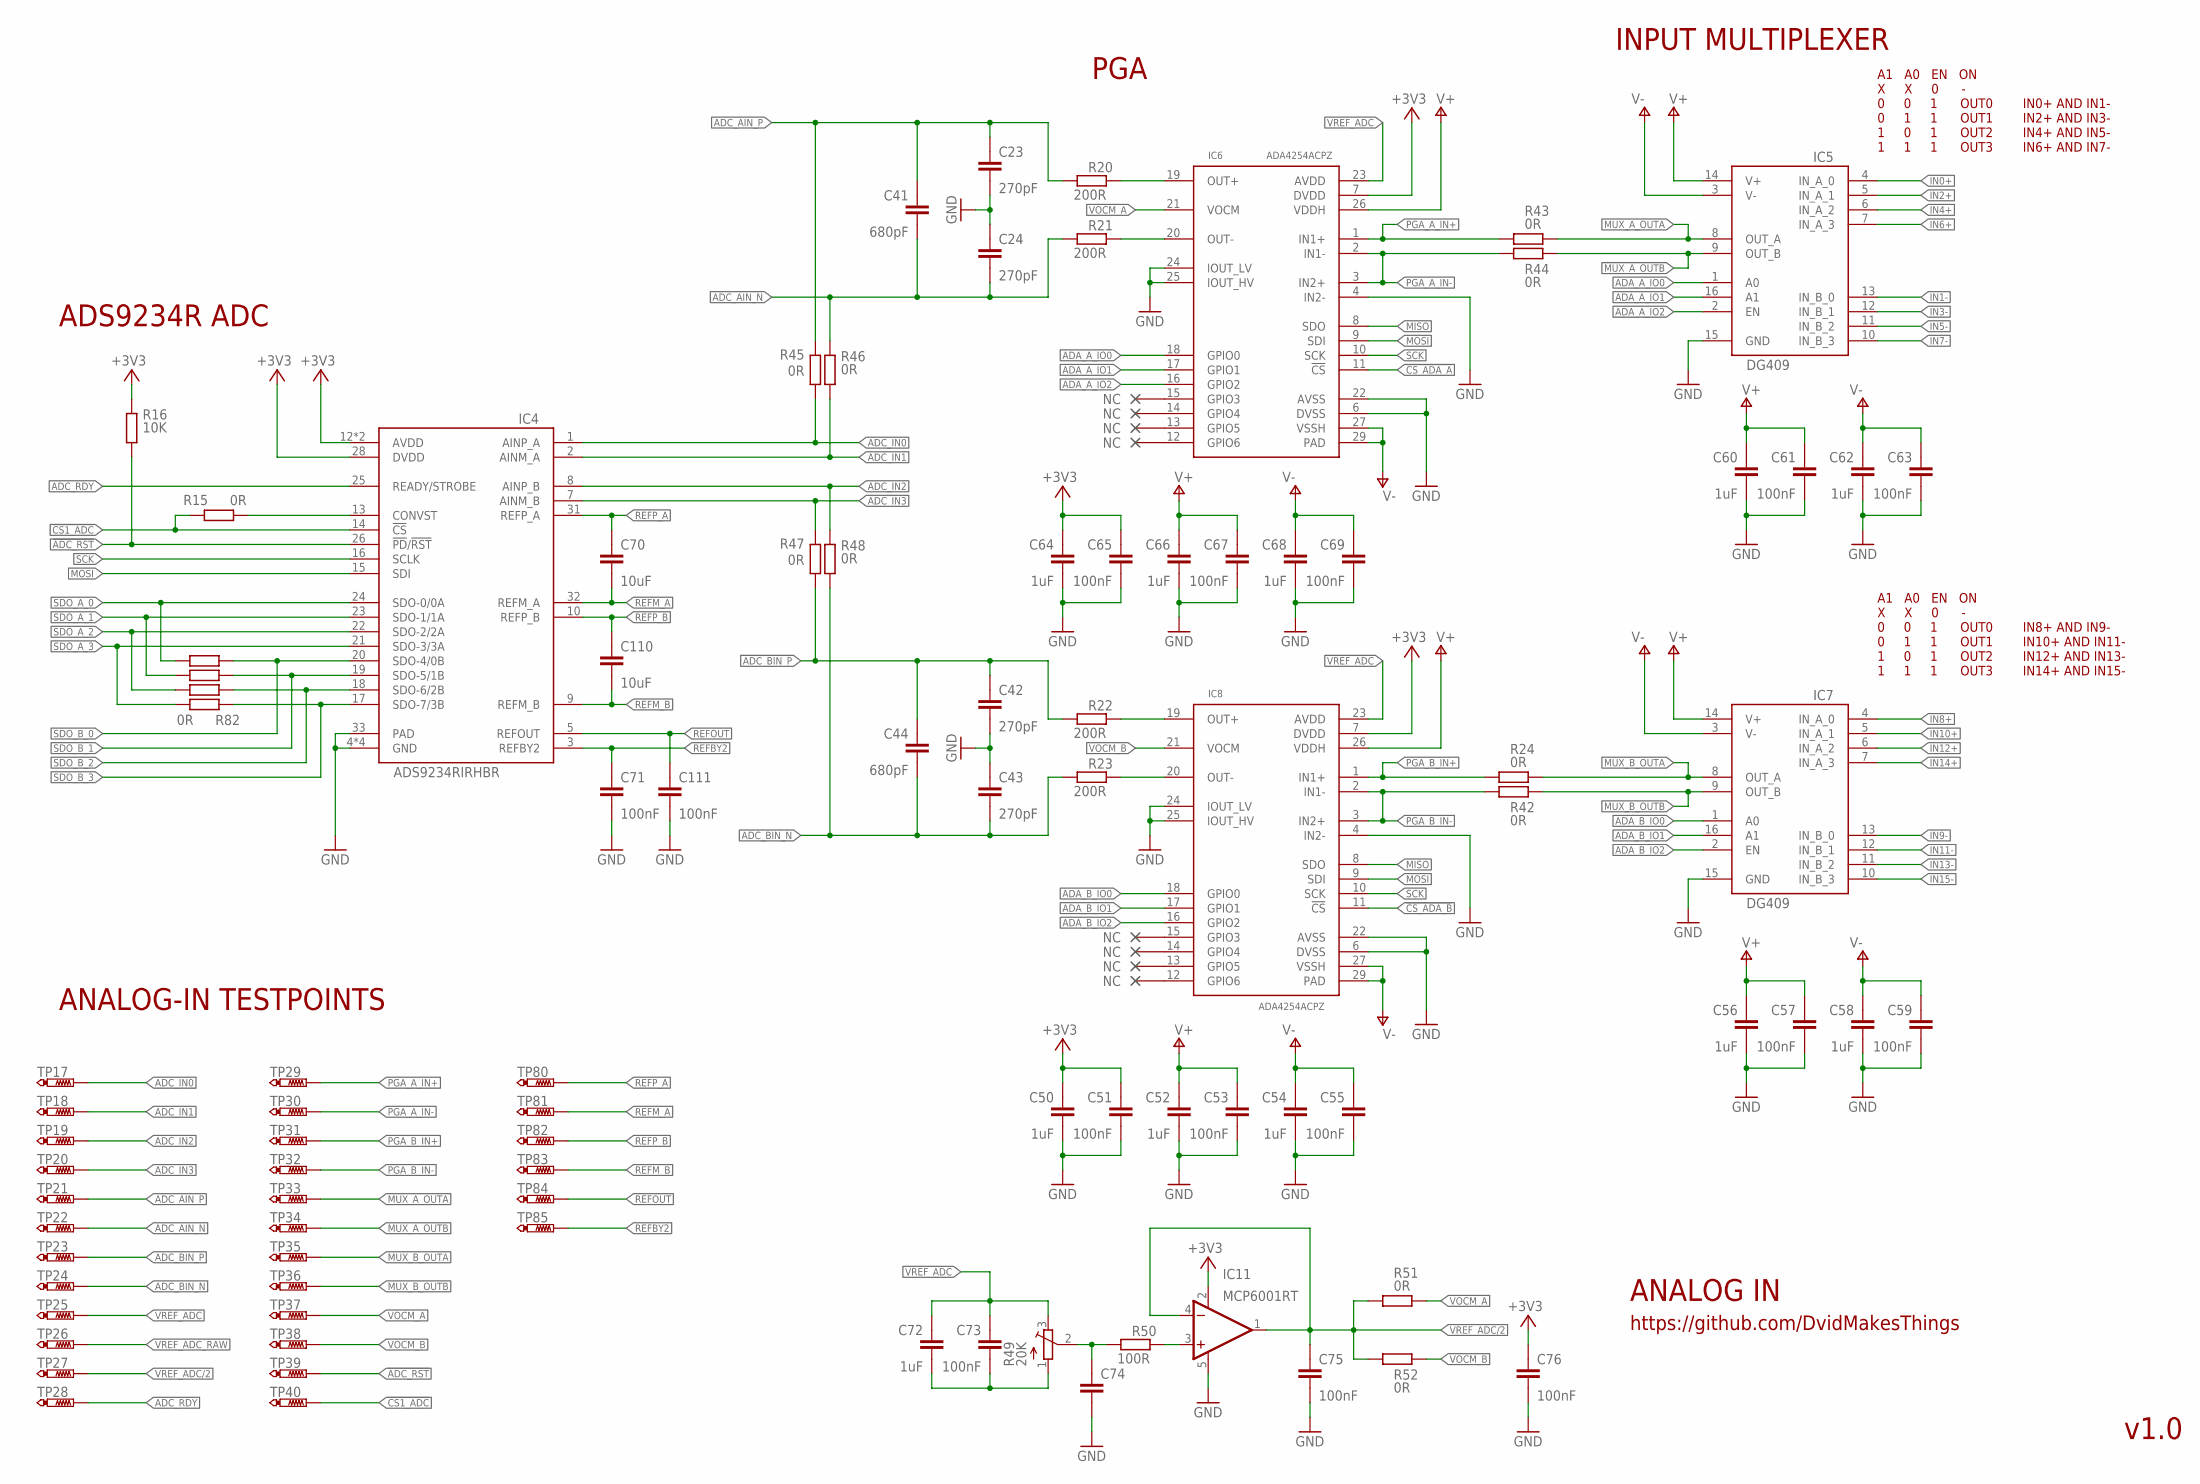
[picture p10: schematic DataForge-DAQ.sch, sheet 5]

Parts:
C23, C24, C42, C43: 270pF; 0402
C41, C44: 680pF; 0402
C50, C52, C54, C56, C58, C60, C62, C64, C66, C68, C72: 1uF; 0603
C51, C53, C55, C57, C59, C61, C63, C65, C67, C69, C71, C73, C111: 100nF; 0603
C70, C110: 10uF; 0805
C74: C0805; 0805
C75, C76: 100nF; 0402
IC4: ADS9234RIRHBR; VQFN32-5X5
IC5, IC7: DG409; TSSOP16
IC6, IC8: ADA4254ACPZ; QFN50P500X500X75-29T314N
IC11: MCP6001RT; SOT23-5
R15, R17, R18, R81, R82: 0R; 0402
R16: 10K; 0402
R20, R21, R22, R23: 200R; 0402
R24, R42, R43, R44, R45, R46, R47, R48, R51, R52: 0R; 0603
R49: 20K; 3223G
R50: 100R; 0402
TP17, TP18, TP19, TP20, TP21, TP22, TP23, TP24, TP25, TP26, TP27, TP28, TP29, TP30, TP31, TP32, TP33, TP34, TP35, TP36, TP37, TP38, TP39, TP40, TP80, TP81, TP82, TP83, TP84, TP85: PTR1B1,27; B1,27

Connections:
!ADC_RST: IC4.26 (!PD!/!RST), R16.2, TP39.TP
!CS1_ADC: IC4.14 (!CS), R15.1, TP40.TP
!CS_ADA_A: IC6.11 (!CS)
!CS_ADA_B: IC8.11 (!CS)
+3V3: C50.1, C51.1, C64.1, C65.1, C76.1, IC4.12 (AVDD), IC4.28 (DVDD), IC6.7 (DVDD), IC8.7 (DVDD), IC11.2 (V+), R16.1
ADA_A_IO0: IC5.1 (A0), IC6.18 (GPIO0)
ADA_A_IO1: IC5.16 (A1), IC6.17 (GPIO1)
ADA_A_IO2: IC5.2 (EN), IC6.16 (GPIO2)
ADA_B_IO0: IC7.1 (A0), IC8.18 (GPIO0)
ADA_B_IO1: IC7.16 (A1), IC8.17 (GPIO1)
ADA_B_IO2: IC7.2 (EN), IC8.16 (GPIO2)
ADC_AIN_N: C24.2, C41.2, R21.1, R46.1, TP22.TP
ADC_AIN_P: C23.1, C41.1, R20.1, R45.2, TP21.TP
ADC_BIN_N: C43.2, C44.2, R23.1, R48.2, TP24.TP
ADC_BIN_P: C42.1, C44.1, R22.1, R47.1, TP23.TP
ADC_IN0: IC4.1 (AINP_A), R45.1, TP17.TP
ADC_IN1: IC4.2 (AINM_A), R46.2, TP18.TP
ADC_IN2: IC4.8 (AINP_B), R48.1, TP19.TP
ADC_IN3: IC4.7 (AINM_B), R47.2, TP20.TP
ADC_RDY: IC4.25 (READY/STROBE), TP28.TP
GND: C23.2, C24.1, C42.2, C43.1, C50.2, C51.2, C52.2, C53.2, C54.2, C55.2, C56.2, C57.2, C58.2, C59.2, C60.2, C61.2, C62.2, C63.2, C64.2, C65.2, C66.2, C67.2, C68.2, C69.2, C71.2, C74.2, C75.2, C76.2, C111.2, IC4.4 (GND), IC4.33 (PAD), IC5.15 (GND), IC6.4 (IN2-), IC6.6 (DVSS), IC6.22 (AVSS), IC6.24 (IOUT_LV), IC6.25 (IOUT_HV), IC7.15 (GND), IC8.4 (IN2-), IC8.6 (DVSS), IC8.22 (AVSS), IC8.24 (IOUT_LV), IC8.25 (IOUT_HV), IC11.5 (V-)
IN0+: IC5.4 (IN_A_0)
IN1-: IC5.13 (IN_B_0)
IN2+: IC5.5 (IN_A_1)
IN3-: IC5.12 (IN_B_1)
IN4+: IC5.6 (IN_A_2)
IN5-: IC5.11 (IN_B_2)
IN6+: IC5.7 (IN_A_3)
IN7-: IC5.10 (IN_B_3)
IN8+: IC7.4 (IN_A_0)
IN9-: IC7.13 (IN_B_0)
IN10+: IC7.5 (IN_A_1)
IN11-: IC7.12 (IN_B_1)
IN12+: IC7.6 (IN_A_2)
IN13-: IC7.11 (IN_B_2)
IN14+: IC7.7 (IN_A_3)
IN15-: IC7.10 (IN_B_3)
MISO: IC6.8 (SDO), IC8.8 (SDO)
MOSI: IC4.15 (SDI), IC6.9 (SDI), IC8.9 (SDI)
MUX_A_OUTA: IC5.8 (OUT_A), R43.2, TP33.TP
MUX_A_OUTB: IC5.9 (OUT_B), R44.1, TP34.TP
MUX_B_OUTA: IC7.8 (OUT_A), R24.2, TP35.TP
MUX_B_OUTB: IC7.9 (OUT_B), R42.1, TP36.TP
unnamed: IC4.13 (CONVST), R15.2
unnamed: C74.1, R49.2 (S), R50.1
unnamed: C72.2, C73.2, R49.1 (A)
unnamed: IC6.19 (OUT+), R20.2
unnamed: IC6.20 (OUT-), R21.2
unnamed: IC11.3 (+IN), R50.2
unnamed: IC8.19 (OUT+), R22.2
unnamed: IC8.20 (OUT-), R23.2
PGA_A_IN+: IC6.1 (IN1+), R43.1, TP29.TP
PGA_A_IN-: IC6.2 (IN1-), IC6.3 (IN2+), R44.2, TP30.TP
PGA_B_IN+: IC8.1 (IN1+), R24.1, TP31.TP
PGA_B_IN-: IC8.2 (IN1-), IC8.3 (IN2+), R42.2, TP32.TP
REFBY2: C71.1, IC4.3 (REFBY2), TP85.TP
REFM_A: C70.2, IC4.32 (REFM_A), TP81.TP
REFM_B: C110.2, IC4.9 (REFM_B), TP83.TP
REFOUT: C111.1, IC4.5 (REFOUT), TP84.TP
REFP_A: C70.1, IC4.31 (REFP_A), TP80.TP
REFP_B: C110.1, IC4.10 (REFP_B), TP82.TP
SCK: IC4.16 (SCLK), IC6.10 (SCK), IC8.10 (SCK)
SDO_A_0: IC4.24 (SDO-0/0A), R17.2
SDO_A_1: IC4.23 (SDO-1/1A), R18.2
SDO_A_2: IC4.22 (SDO-2/2A), R81.2
SDO_A_3: IC4.21 (SDO-3/3A), R82.2
SDO_B_0: IC4.20 (SDO-4/0B), R17.1
SDO_B_1: IC4.19 (SDO-5/1B), R18.1
SDO_B_2: IC4.18 (SDO-6/2B), R81.1
SDO_B_3: IC4.17 (SDO-7/3B), R82.1
V+: C52.1, C53.1, C56.1, C57.1, C60.1, C61.1, C66.1, C67.1, IC5.14 (V+), IC6.26 (VDDH), IC7.14 (V+), IC8.26 (VDDH)
V-: C54.1, C55.1, C58.1, C59.1, C62.1, C63.1, C68.1, C69.1, IC5.3 (V-), IC6.27 (VSSH), IC6.29 (PAD), IC7.3 (V-), IC8.27 (VSSH), IC8.29 (PAD)
VOCM_A: IC6.21 (VOCM), R51.2, TP37.TP
VOCM_B: IC8.21 (VOCM), R52.1, TP38.TP
VREF_ADC: C72.1, C73.1, IC6.23 (AVDD), IC8.23 (AVDD), R49.3 (E), TP25.TP
VREF_ADC/2: C75.1, IC11.1 (OUT), IC11.4 (-IN), R51.1, R52.2, TP27.TP
VREF_ADC_RAW: TP26.TP

Notes on the sheet:
v1.0
https://github.com/DvidMakesThings
ANALOG IN
ADS9234R ADC
A1 A0 EN ON
X X 0 -
0 0 1 OUT0
0 1 1 OUT1
1 0 1 OUT2
1 1 1 OUT3
IN0+ AND IN1-
IN2+ AND IN3-
IN4+ AND IN5-
IN6+ AND IN7-
IN8+ AND IN9-
IN10+ AND IN11-
IN12+ AND IN13-
IN14+ AND IN15-
ANALOG-IN TESTPOINTS
PGA
INPUT MULTIPLEXER
