DvidMakesThings/HW_DataForge-DAQ/src/HardwareDesign/DataForge-DAQ.sch

## EAGLE design src/HardwareDesign/DataForge-DAQ.sch (continued)

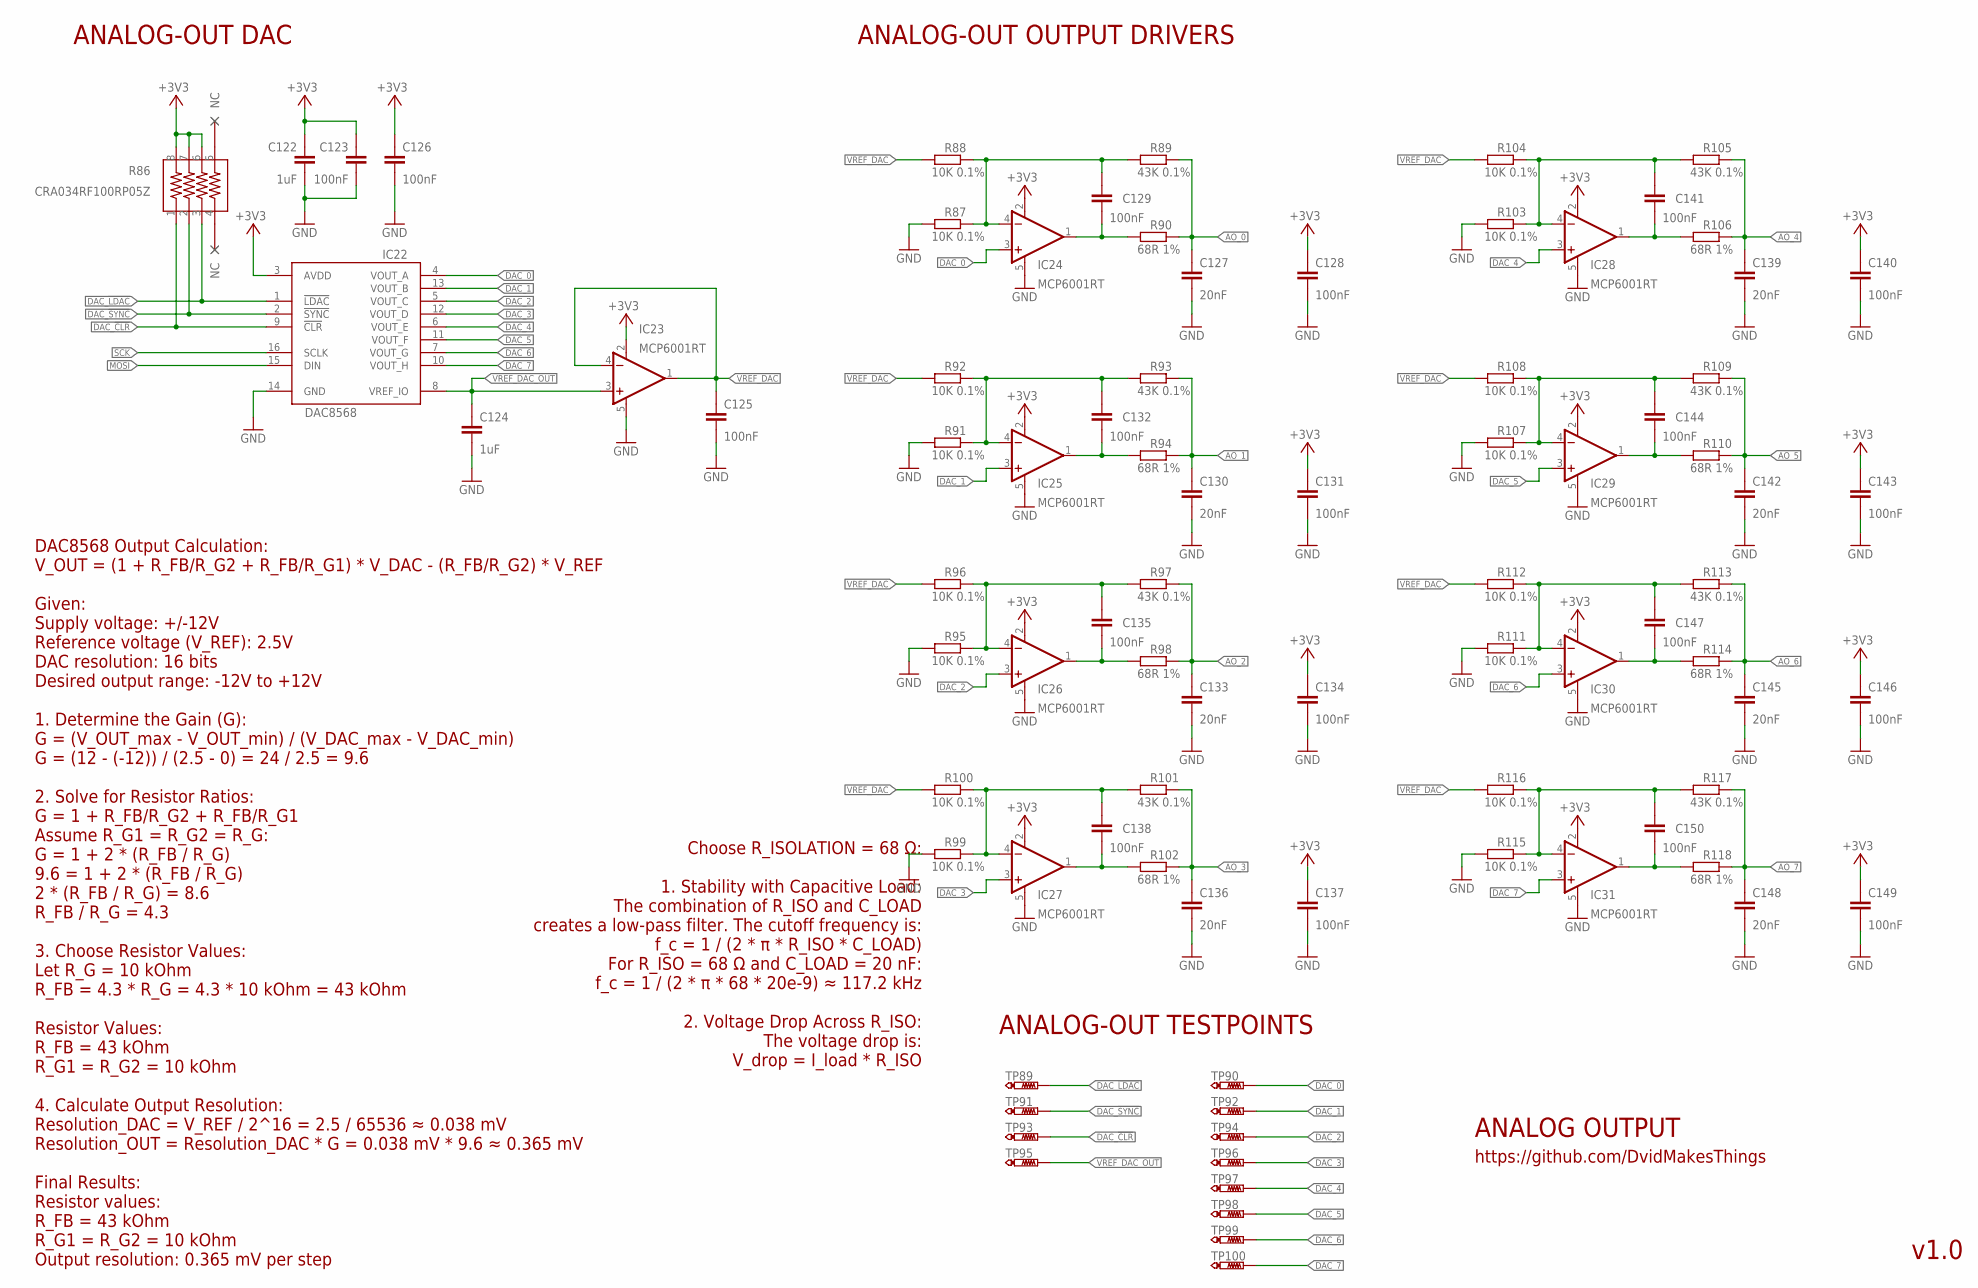
[picture p11: schematic DataForge-DAQ.sch, sheet 6]

Parts:
C122, C124: 1uF; 0603
C123: 100nF; 0603
C125, C126, C128, C129, C131, C132, C134, C135, C137, C138, C140, C141, C143, C144, C146, C147, C149, C150: 100nF; 0402
C127, C130, C133, C136, C139, C142, C145, C148: 20nF; 0402
IC22: DAC8568; TSSOP16
IC23, IC24, IC25, IC26, IC27, IC28, IC29, IC30, IC31: MCP6001RT; SOT23-5
R86: CRA034RF100RP05Z; YC164-JR-0733RL
R87, R88, R91, R92, R95, R96, R99, R100, R103, R104, R107, R108, R111, R112, R115, R116: 10K 0.1%; 0402
R89, R93, R97, R101, R105, R109, R113, R117: 43K 0.1%; 0402
R90, R94, R98, R102, R106, R110, R114, R118: 68R 1%; 0402
TP89, TP90, TP91, TP92, TP93, TP94, TP95, TP96, TP97, TP98, TP99, TP100: PTR1B1,27; B1,27

Connections:
+3V3: C122.1, C123.1, C126.1, C128.1, C131.1, C134.1, C137.1, C140.1, C143.1, C146.1, C149.1, IC22.3 (AVDD), IC23.2 (V+), IC24.2 (V+), IC25.2 (V+), IC26.2 (V+), IC27.2 (V+), IC28.2 (V+), IC29.2 (V+), IC30.2 (V+), IC31.2 (V+), R86.6, R86.7, R86.8
AO_0: C127.1, R89.2, R90.2
AO_1: C130.1, R93.2, R94.2
AO_2: C133.1, R97.2, R98.2
AO_3: C136.1, R101.2, R102.2
AO_4: C139.1, R105.2, R106.2
AO_5: C142.1, R109.2, R110.2
AO_6: C145.1, R113.2, R114.2
AO_7: C148.1, R117.2, R118.2
DAC_0: IC22.4 (VOUT_A), IC24.3 (+IN), TP90.TP
DAC_1: IC22.13 (VOUT_B), IC25.3 (+IN), TP92.TP
DAC_2: IC22.5 (VOUT_C), IC26.3 (+IN), TP94.TP
DAC_3: IC22.12 (VOUT_D), IC27.3 (+IN), TP96.TP
DAC_4: IC22.6 (VOUT_E), IC28.3 (+IN), TP97.TP
DAC_5: IC22.11 (VOUT_F), IC29.3 (+IN), TP98.TP
DAC_6: IC22.7 (VOUT_G), IC30.3 (+IN), TP99.TP
DAC_7: IC22.10 (VOUT_H), IC31.3 (+IN), TP100.TP
DAC_!CLR: IC22.9 (!CLR), R86.1, TP93.TP
DAC_!LDAC: IC22.1 (!LDAC), R86.3, TP89.TP
DAC_!SYNC: IC22.2 (!SYNC), R86.2, TP91.TP
GND: C122.2, C123.2, C124.2, C125.2, C126.2, C127.2, C128.2, C130.2, C131.2, C133.2, C134.2, C136.2, C137.2, C139.2, C140.2, C142.2, C143.2, C145.2, C146.2, C148.2, C149.2, IC22.14 (GND), IC23.5 (V-), IC24.5 (V-), IC25.5 (V-), IC26.5 (V-), IC27.5 (V-), IC28.5 (V-), IC29.5 (V-), IC30.5 (V-), IC31.5 (V-), R87.1, R91.1, R95.1, R99.1, R103.1, R107.1, R111.1, R115.1
MOSI: IC22.15 (DIN)
unnamed: C129.2, IC24.1 (OUT), R90.1
unnamed: C129.1, IC24.4 (-IN), R87.2, R88.2, R89.1
unnamed: C132.1, IC25.4 (-IN), R91.2, R92.2, R93.1
unnamed: C132.2, IC25.1 (OUT), R94.1
unnamed: C135.1, IC26.4 (-IN), R95.2, R96.2, R97.1
unnamed: C135.2, IC26.1 (OUT), R98.1
unnamed: C138.1, IC27.4 (-IN), R99.2, R100.2, R101.1
unnamed: C138.2, IC27.1 (OUT), R102.1
unnamed: C141.1, IC28.4 (-IN), R103.2, R104.2, R105.1
unnamed: C141.2, IC28.1 (OUT), R106.1
unnamed: C144.1, IC29.4 (-IN), R107.2, R108.2, R109.1
unnamed: C144.2, IC29.1 (OUT), R110.1
unnamed: C147.1, IC30.4 (-IN), R111.2, R112.2, R113.1
unnamed: C147.2, IC30.1 (OUT), R114.1
unnamed: C150.1, IC31.4 (-IN), R115.2, R116.2, R117.1
unnamed: C150.2, IC31.1 (OUT), R118.1
SCK: IC22.16 (SCLK)
VREF_DAC: C125.1, IC23.1 (OUT), IC23.4 (-IN), R88.1, R92.1, R96.1, R100.1, R104.1, R108.1, R112.1, R116.1
VREF_DAC_OUT: C124.1, IC22.8 (VREF_IO), IC23.3 (+IN), TP95.TP

Notes on the sheet:
v1.0
https://github.com/DvidMakesThings
ANALOG OUTPUT
DAC8568 Output Calculation: V_OUT = (1 + R_FB/R_G2 + R_FB/R_G1) * V_DAC - (R_FB/R_G2) * V_REF Given: Supply voltage: +/-12V Reference voltage (V_REF): 2.5V DAC resolution: 16 bits Desired output range: -12V to +12V 1. Determine the Gain (G): G = (V_OUT_max - V_OUT_min) / (V_DAC_max - V_DAC_min) G =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
Choose R_ISOLATION = 68 Ω: 1. Stability with Capacitive Load: The combination of R_ISO and C_LOAD creates a low-pass filter. The cutoff frequency is: f_c = 1 / (2 * π * R_ISO * C_LOAD) For R_ISO = 68 Ω and C_LOAD = 20 nF: f_c = 1 / (2 * π * 68 * 20e-9) ≈ 117.2 kHz 2. Voltage Drop Across R_ISO: The 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
ANALOG-OUT TESTPOINTS
ANALOG-OUT DAC
ANALOG-OUT OUTPUT DRIVERS

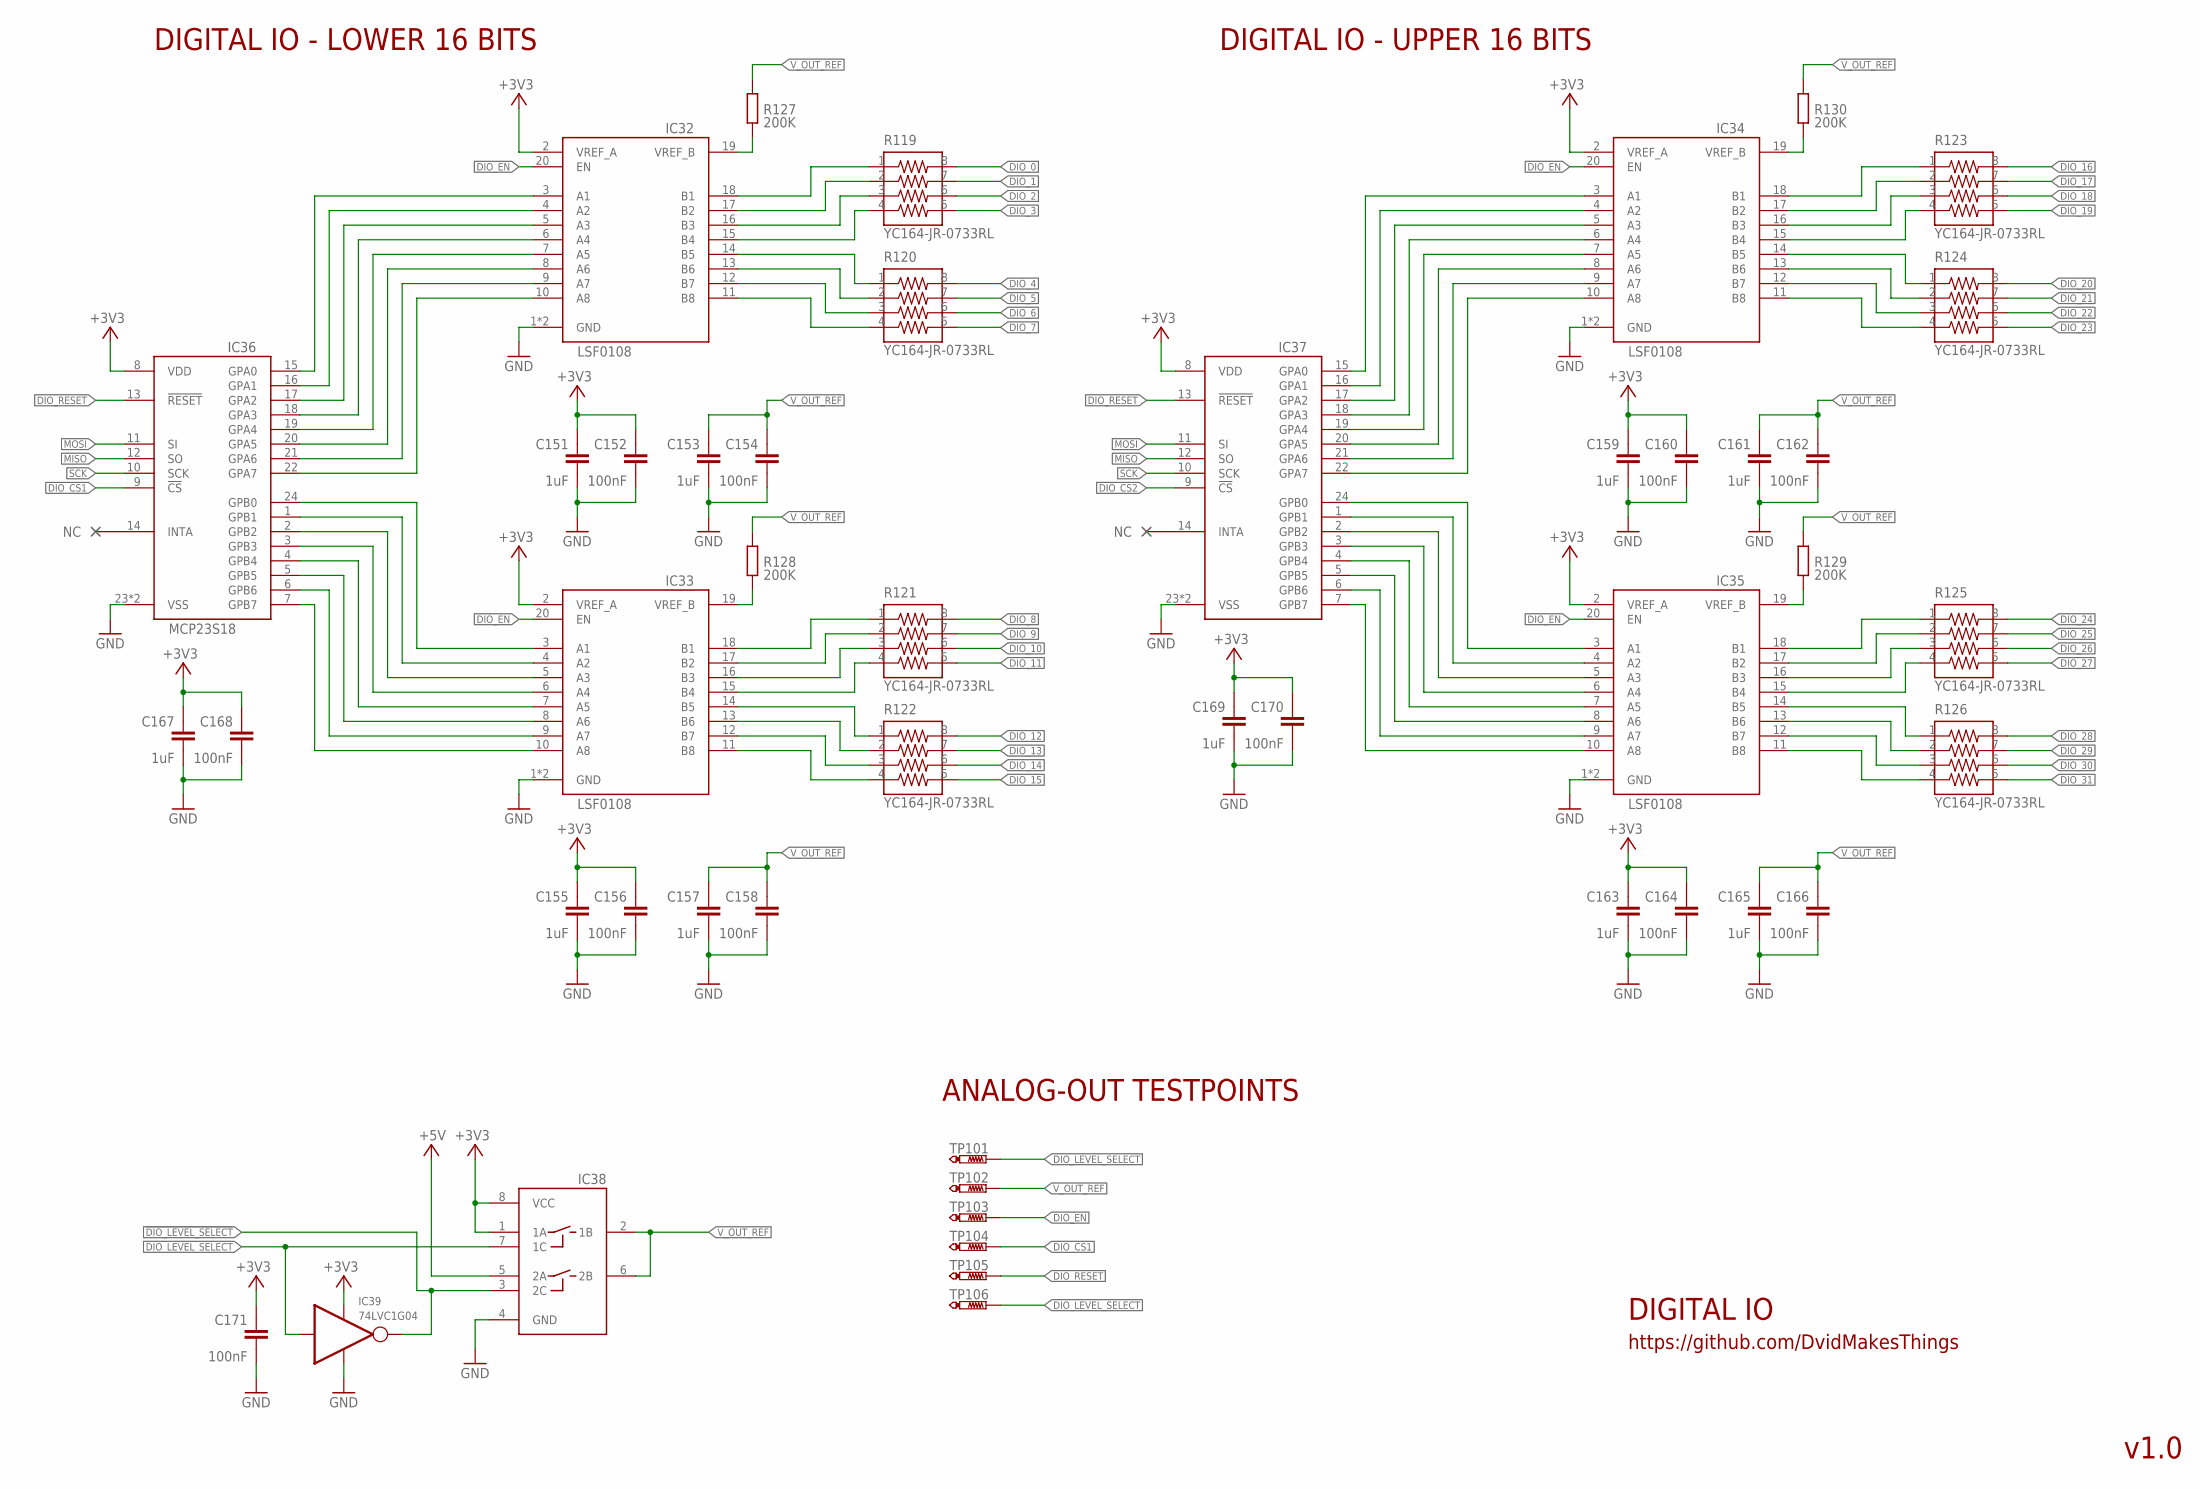
[picture p12: schematic DataForge-DAQ.sch, sheet 7]

Parts:
C151, C153, C155, C157, C159, C161, C163, C165, C167, C169: 1uF; 0603
C152, C154, C156, C158, C160, C162, C164, C166, C168, C170, C171: 100nF; 0603
IC32, IC33, IC34, IC35: LSF0108; VQFN20
IC36, IC37: MCP23S18; QFN50P400X400X100-25T265
IC38: SN74LVC2G66; SOP50P310X90-8N
IC39: 74LVC1G04; SOT95P280X145-5N
R119, R120, R121, R122, R123, R124, R125, R126: YC164-JR-0733RL
R127, R128, R129, R130: 200K; 0402
TP101, TP102, TP103, TP104, TP105, TP106: PTR1B1,27; B1,27

Connections:
!DIO_LEVEL_SELECT: IC38.3 (2C), IC39.4 (OUT)
+3V3: C151.1, C152.1, C155.1, C156.1, C159.1, C160.1, C163.1, C164.1, C167.1, C168.1, C169.1, C170.1, C171.1, IC32.2 (VREF_A), IC33.2 (VREF_A), IC34.2 (VREF_A), IC35.2 (VREF_A), IC36.8 (VDD), IC37.8 (VDD), IC38.1 (1A), IC38.8 (VCC), IC39.5 (V+)
+5V: IC38.5 (2A)
DIO_0: R119.8
DIO_1: R119.7
DIO_2: R119.6
DIO_3: R119.5
DIO_4: R120.8
DIO_5: R120.7
DIO_6: R120.6
DIO_7: R120.5
DIO_8: R121.8
DIO_9: R121.7
DIO_10: R121.6
DIO_11: R121.5
DIO_12: R122.8
DIO_13: R122.7
DIO_14: R122.6
DIO_15: R122.5
DIO_16: R123.8
DIO_17: R123.7
DIO_18: R123.6
DIO_19: R123.5
DIO_20: R124.8
DIO_21: R124.7
DIO_22: R124.6
DIO_23: R124.5
DIO_24: R125.8
DIO_25: R125.7
DIO_26: R125.6
DIO_27: R125.5
DIO_28: R126.8
DIO_29: R126.7
DIO_30: R126.6
DIO_31: R126.5
DIO_CS1: IC36.9 (!CS), TP104.TP
DIO_CS2: IC37.9 (!CS)
DIO_EN: IC32.20 (EN), IC33.20 (EN), IC34.20 (EN), IC35.20 (EN), TP103.TP
DIO_LEVEL_SELECT: IC38.7 (1C), IC39.2 (IN), TP101.TP, TP106.TP
DIO_RESET: IC36.13 (!RESET), IC37.13 (!RESET), TP105.TP
GND: C151.2, C152.2, C153.2, C154.2, C155.2, C156.2, C157.2, C158.2, C159.2, C160.2, C161.2, C162.2, C163.2, C164.2, C165.2, C166.2, C167.2, C168.2, C169.2, C170.2, C171.2, IC32.1 (GND), IC33.1 (GND), IC34.1 (GND), IC35.1 (GND), IC36.23 (VSS), IC37.23 (VSS), IC38.4 (GND), IC39.3 (V-)
MISO: IC36.12 (SO), IC37.12 (SO)
MOSI: IC36.11 (SI), IC37.11 (SI)
unnamed: IC33.4 (A2), IC36.1 (GPB1)
unnamed: IC32.3 (A1), IC36.15 (GPA0)
unnamed: IC32.4 (A2), IC36.16 (GPA1)
unnamed: IC32.5 (A3), IC36.17 (GPA2)
unnamed: IC32.6 (A4), IC36.18 (GPA3)
unnamed: IC32.7 (A5), IC36.19 (GPA4)
unnamed: IC32.8 (A6), IC36.20 (GPA5)
unnamed: IC32.9 (A7), IC36.21 (GPA6)
unnamed: IC32.10 (A8), IC36.22 (GPA7)
unnamed: IC32.18 (B1), R119.1
unnamed: IC32.17 (B2), R119.2
unnamed: IC32.16 (B3), R119.3
unnamed: IC32.15 (B4), R119.4
unnamed: IC32.14 (B5), R120.1
unnamed: IC32.13 (B6), R120.2
unnamed: IC32.12 (B7), R120.3
unnamed: IC32.11 (B8), R120.4
unnamed: IC33.3 (A1), IC36.24 (GPB0)
unnamed: IC33.5 (A3), IC36.2 (GPB2)
unnamed: IC33.6 (A4), IC36.3 (GPB3)
unnamed: IC33.7 (A5), IC36.4 (GPB4)
unnamed: IC33.8 (A6), IC36.5 (GPB5)
unnamed: IC33.9 (A7), IC36.6 (GPB6)
unnamed: IC33.10 (A8), IC36.7 (GPB7)
unnamed: IC33.18 (B1), R121.1
unnamed: IC33.17 (B2), R121.2
unnamed: IC33.16 (B3), R121.3
unnamed: IC33.15 (B4), R121.4
unnamed: IC33.14 (B5), R122.1
unnamed: IC33.13 (B6), R122.2
unnamed: IC33.12 (B7), R122.3
unnamed: IC33.11 (B8), R122.4
unnamed: IC34.3 (A1), IC37.15 (GPA0)
unnamed: IC34.4 (A2), IC37.16 (GPA1)
unnamed: IC34.5 (A3), IC37.17 (GPA2)
unnamed: IC34.6 (A4), IC37.18 (GPA3)
unnamed: IC34.7 (A5), IC37.19 (GPA4)
unnamed: IC34.8 (A6), IC37.20 (GPA5)
unnamed: IC34.9 (A7), IC37.21 (GPA6)
unnamed: IC34.10 (A8), IC37.22 (GPA7)
unnamed: IC34.18 (B1), R123.1
unnamed: IC34.17 (B2), R123.2
unnamed: IC34.16 (B3), R123.3
unnamed: IC34.15 (B4), R123.4
unnamed: IC34.14 (B5), R124.1
unnamed: IC34.13 (B6), R124.2
unnamed: IC34.12 (B7), R124.3
unnamed: IC34.11 (B8), R124.4
unnamed: IC35.5 (A3), IC37.2 (GPB2)
unnamed: IC35.6 (A4), IC37.3 (GPB3)
unnamed: IC35.7 (A5), IC37.4 (GPB4)
unnamed: IC35.8 (A6), IC37.5 (GPB5)
unnamed: IC35.9 (A7), IC37.6 (GPB6)
unnamed: IC35.10 (A8), IC37.7 (GPB7)
unnamed: IC35.4 (A2), IC37.1 (GPB1)
unnamed: IC35.3 (A1), IC37.24 (GPB0)
unnamed: IC35.18 (B1), R125.1
unnamed: IC35.17 (B2), R125.2
unnamed: IC35.16 (B3), R125.3
unnamed: IC35.15 (B4), R125.4
unnamed: IC35.14 (B5), R126.1
unnamed: IC35.13 (B6), R126.2
unnamed: IC35.12 (B7), R126.3
unnamed: IC35.11 (B8), R126.4
unnamed: IC32.19 (VREF_B), R127.1
unnamed: IC33.19 (VREF_B), R128.1
unnamed: IC35.19 (VREF_B), R129.1
unnamed: IC34.19 (VREF_B), R130.1
SCK: IC36.10 (SCK), IC37.10 (SCK)
V_OUT_REF: C153.1, C154.1, C157.1, C158.1, C161.1, C162.1, C165.1, C166.1, IC38.2 (1B), IC38.6 (2B), R127.2, R128.2, R129.2, R130.2, TP102.TP

Notes on the sheet:
v1.0
https://github.com/DvidMakesThings
DIGITAL IO
DIGITAL IO - LOWER 16 BITS
DIGITAL IO - UPPER 16 BITS
ANALOG-OUT TESTPOINTS

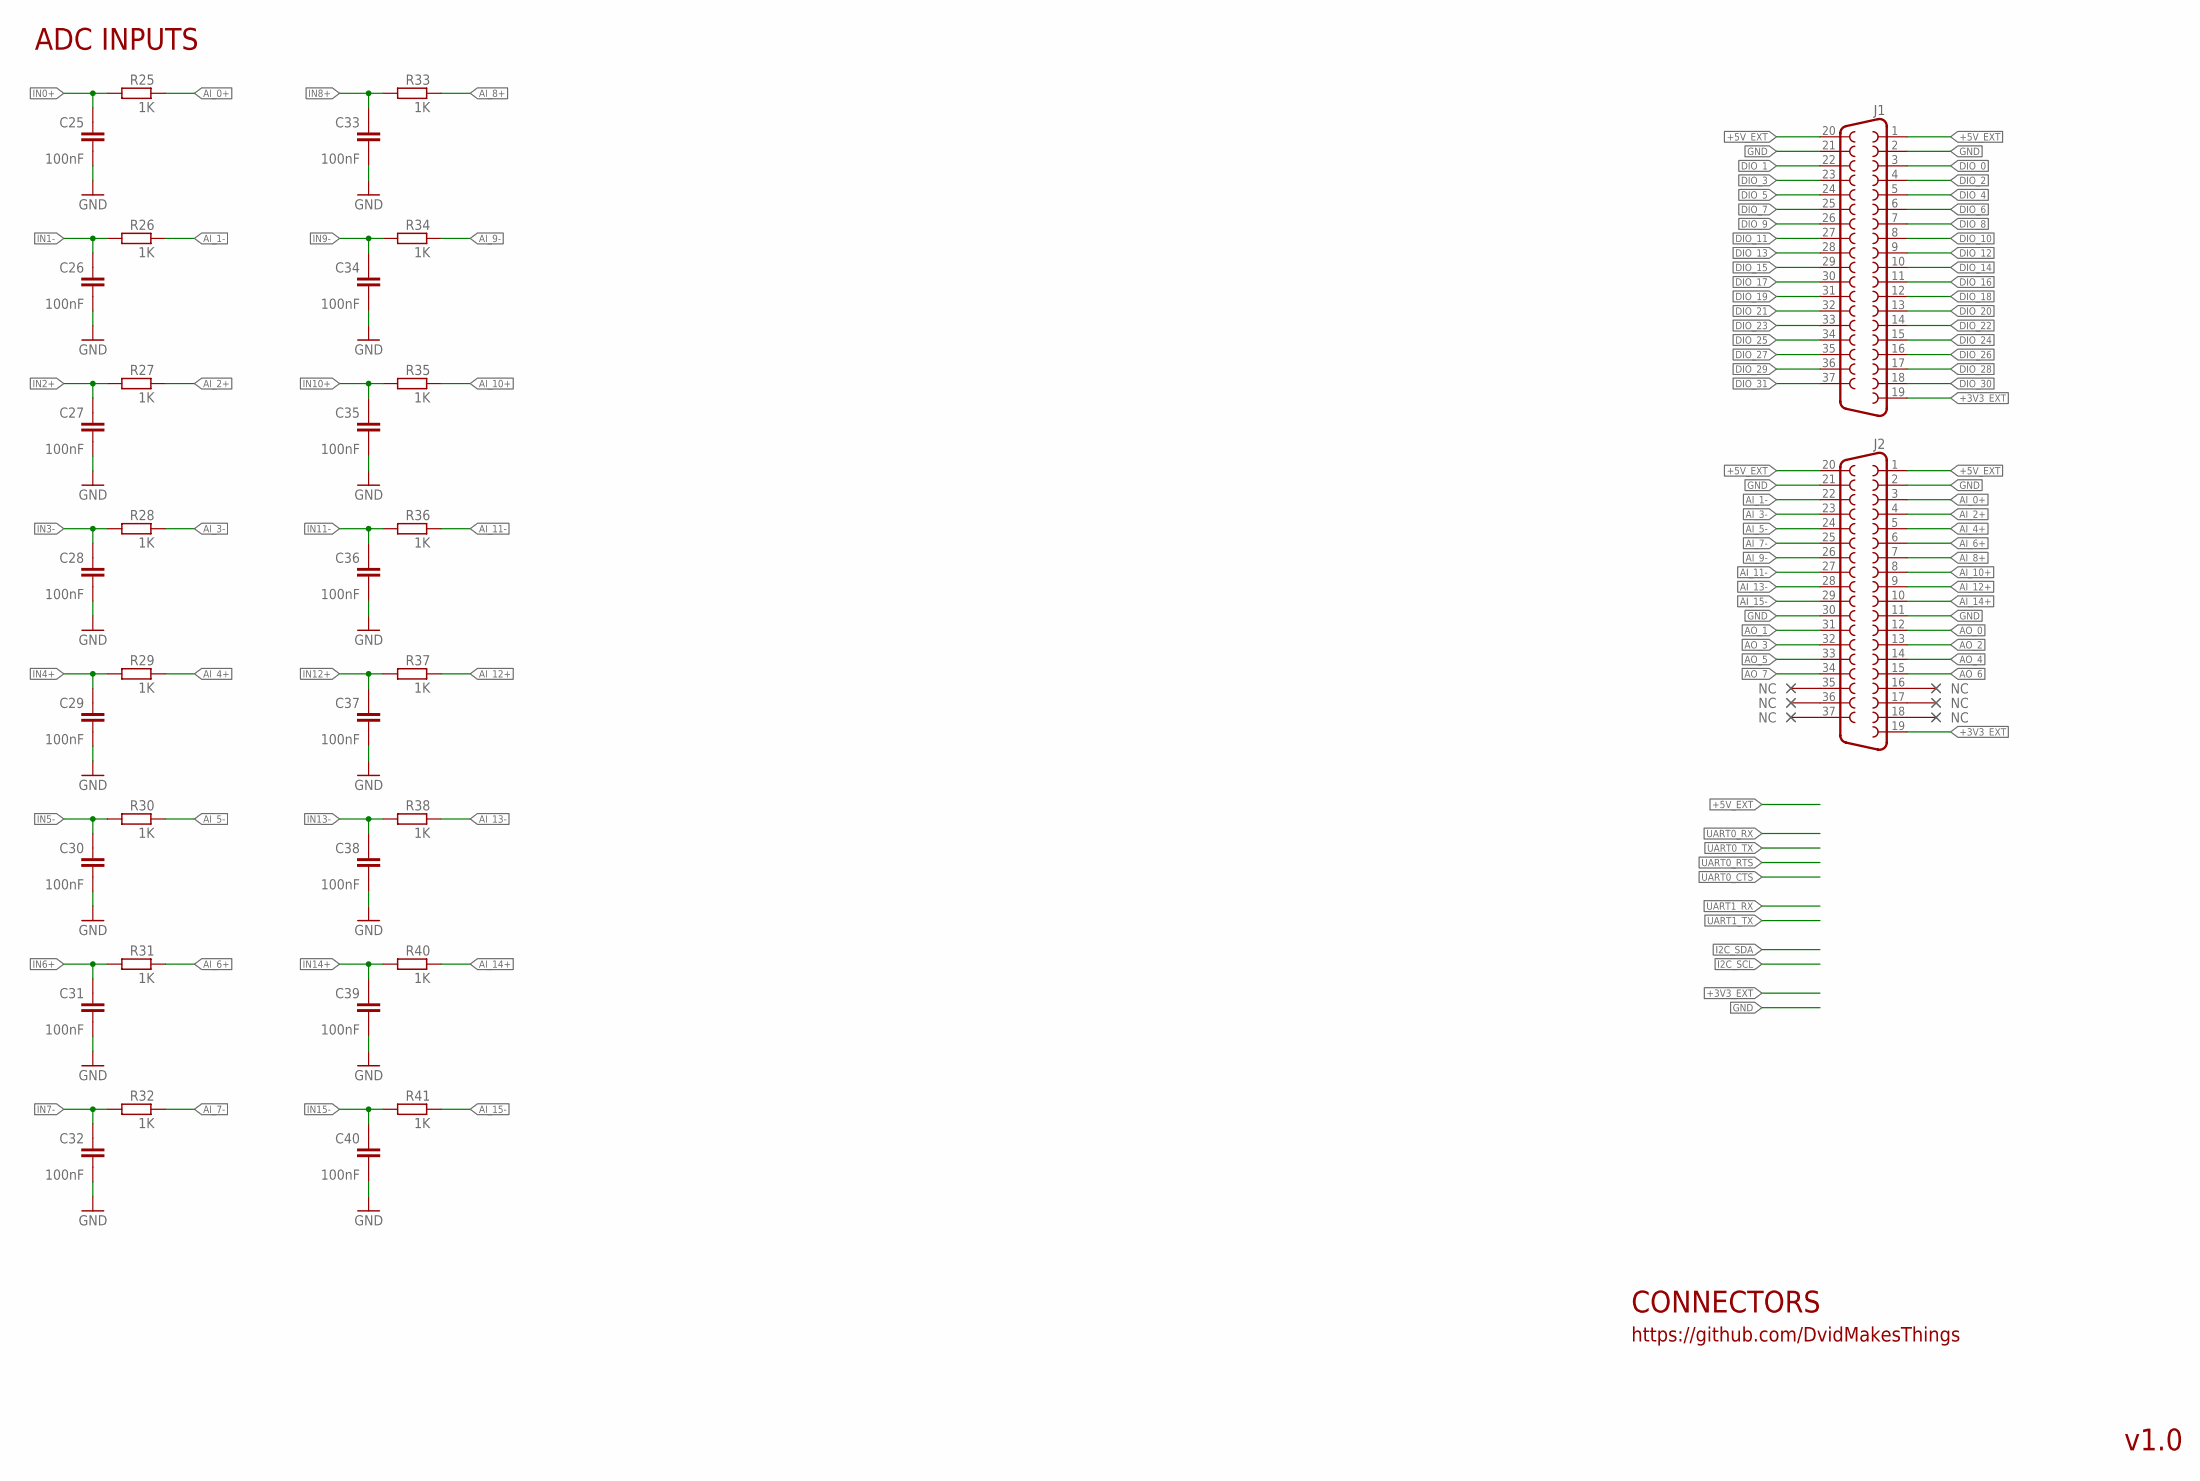
[picture p13: schematic DataForge-DAQ.sch, sheet 8]

Parts:
C25, C26, C27, C28, C29, C30, C31, C32, C33, C34, C35, C36, C37, C38, C39, C40: 100nF; 0603
J1, J2: F37V
R25, R26, R27, R28, R29, R30, R31, R32, R33, R34, R35, R36, R37, R38, R40, R41: 1K; 0603

Connections:
+3V3_EXT: J1.19, J2.19
+5V_EXT: J1.1, J1.20, J2.1, J2.20
AI_0+: J2.3, R25.1
AI_1-: J2.22, R26.1
AI_2+: J2.4, R27.1
AI_3-: J2.23, R28.1
AI_4+: J2.5, R29.1
AI_5-: J2.24, R30.1
AI_6+: J2.6, R31.1
AI_7-: J2.25, R32.1
AI_8+: J2.7, R33.1
AI_9-: J2.26, R34.1
AI_10+: J2.8, R35.1
AI_11-: J2.27, R36.1
AI_12+: J2.9, R37.1
AI_13-: J2.28, R38.1
AI_14+: J2.10, R40.1
AI_15-: J2.29, R41.1
AO_0: J2.12
AO_1: J2.31
AO_2: J2.13
AO_3: J2.32
AO_4: J2.14
AO_5: J2.33
AO_6: J2.15
AO_7: J2.34
DIO_0: J1.3
DIO_1: J1.22
DIO_2: J1.4
DIO_3: J1.23
DIO_4: J1.5
DIO_5: J1.24
DIO_6: J1.6
DIO_7: J1.25
DIO_8: J1.7
DIO_9: J1.26
DIO_10: J1.8
DIO_11: J1.27
DIO_12: J1.9
DIO_13: J1.28
DIO_14: J1.10
DIO_15: J1.29
DIO_16: J1.11
DIO_17: J1.30
DIO_18: J1.12
DIO_19: J1.31
DIO_20: J1.13
DIO_21: J1.32
DIO_22: J1.14
DIO_23: J1.33
DIO_24: J1.15
DIO_25: J1.34
DIO_26: J1.16
DIO_27: J1.35
DIO_28: J1.17
DIO_29: J1.36
DIO_30: J1.18
DIO_31: J1.37
GND: C25.2, C26.2, C27.2, C28.2, C29.2, C30.2, C31.2, C32.2, C33.2, C34.2, C35.2, C36.2, C37.2, C38.2, C39.2, C40.2, J1.2, J1.21, J2.2, J2.11, J2.21, J2.30
IN0+: C25.1, R25.2
IN1-: C26.1, R26.2
IN2+: C27.1, R27.2
IN3-: C28.1, R28.2
IN4+: C29.1, R29.2
IN5-: C30.1, R30.2
IN6+: C31.1, R31.2
IN7-: C32.1, R32.2
IN8+: C33.1, R33.2
IN9-: C34.1, R34.2
IN10+: C35.1, R35.2
IN11-: C36.1, R36.2
IN12+: C37.1, R37.2
IN13-: C38.1, R38.2
IN14+: C39.1, R40.2
IN15-: C40.1, R41.2

Notes on the sheet:
v1.0
https://github.com/DvidMakesThings
CONNECTORS
ADC INPUTS
