DvidMakesThings/HW_DataForge-DAQ/(commit log)

2024-12-15 add MCU
    [DataForge-DAQ.sch]
2024-12-15 review AIN
    [DataForge-DAQ.sch]
2024-12-16 add boost converter and power circuits
2024-12-24 add new ADC
    [DataForge-DAQ.sch]
2024-12-25 add DIO to design
    [DataForge-DAQ.sch]
